nikhi-s/microgap-thermal/simulations/figures/sim1_pressure.pdf

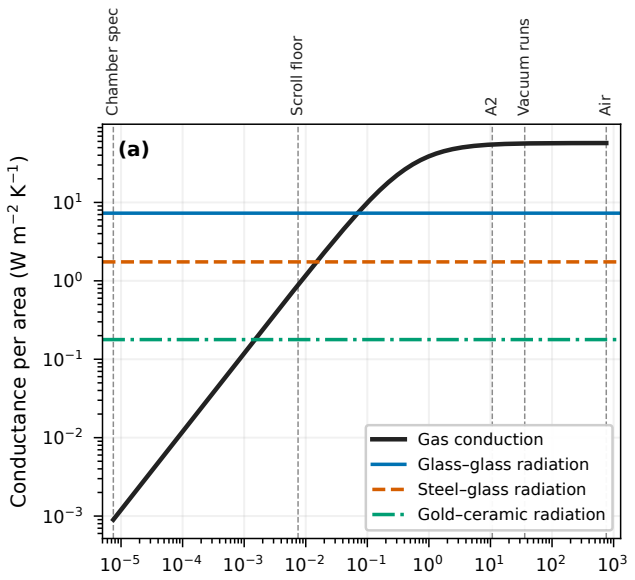
[picture p15: figure]
Conductance per area (W; Chamber spec; Scroll floor; Vacuum runs; Air; Gas conduction

### Absolute pressure (Torr)

Glass–glass radiation Steel–glass radiation Gold–ceramic radiation

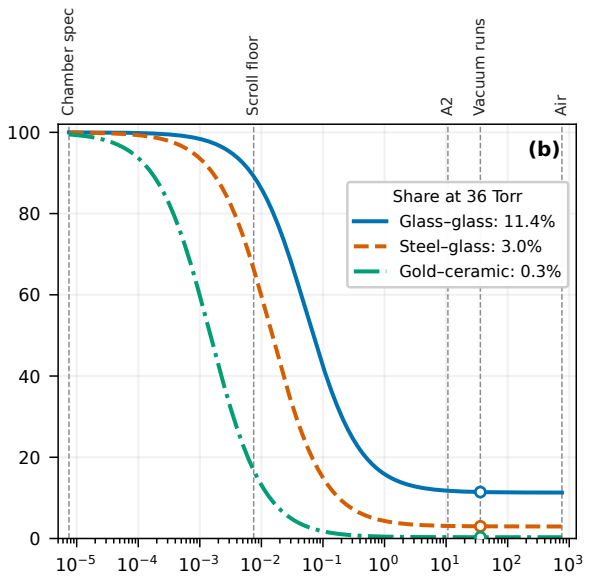
[picture p16: figure]
Chamber spec; Scroll floor; Vacuum runs; Air; Share at 36 Torr

### Absolute pressure (Torr)

### Radiation share of gap heat (%)

Glass–glass: 11.4% Steel–glass: 3.0% Gold–ceramic: 0.3%
