nikhi-s/microgap-thermal/figures/paper/fig4_pressure_map.pdf

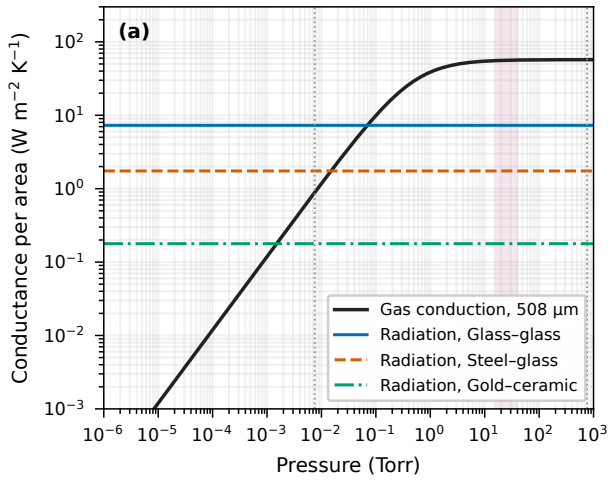
[picture p17: figure]
Pressure (Torr); Conductance per area (W; Gas conduction, 508 µm Radiation, Glass–glass Radiation, Steel–glass Radiation, Gold–ceramic
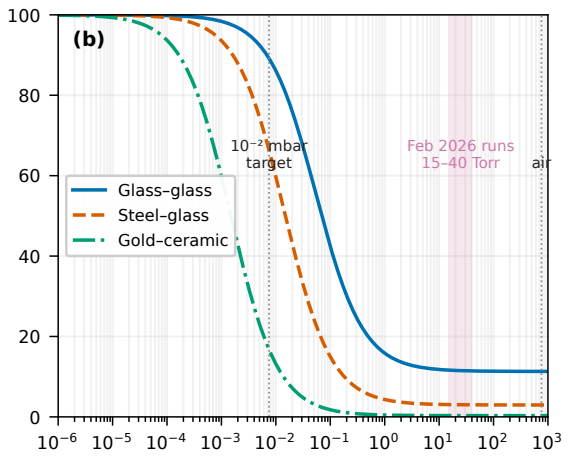
[picture p18: figure]
10⁻² mbar; target; Feb 2026 runs 15–40 Torr; air; Glass–glass Steel–glass Gold–ceramic

### Pressure (Torr)

### Radiation share of gap heat (%)
