nikhi-s/microgap-thermal/figures/paper/fig5_air_null_artifact.pdf

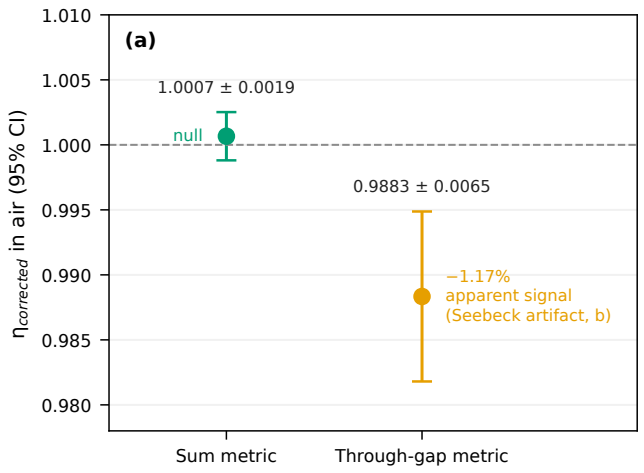
[picture p19: figure]
Sum metric; Through-gap metric; ηcorrected in air (95%; −1.17% apparent signal (Seebeck artifact, b); null
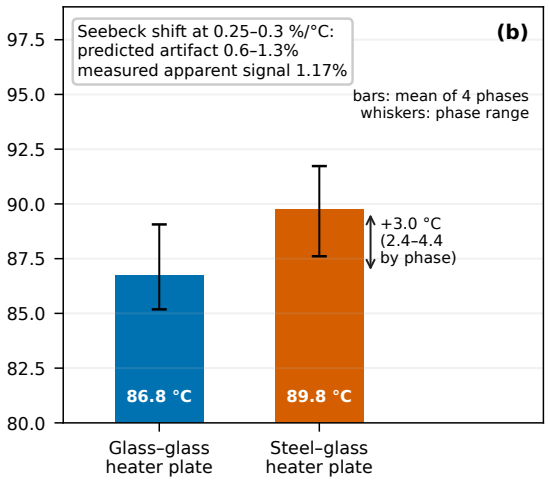
[picture p20: figure]
Glass–glass heater plate; Steel–glass heater plate; bars: mean of 4 phases whiskers: phase range; +3.0 °C (2.4–4.4 by phase); Seebeck shift at 0.25–0.3 %/°C: predicted artifact 0.6–1.3% measured apparent signal 1.17%

### Heated-plate temperature (°C)
