nikhi-s/microgap-thermal/figures/archive_2026-02/README.md

# figures/archive_2026-02/

**Superseded figures — kept for the record. Do not use in new materials.**

These are the figures used in the February 2026 competition materials (DRSEF, GENIUS Olympiad,
Sigma Xi). They are preserved unchanged so that earlier presentations and papers can be traced.
A September 2026 re-analysis of the raw logs found that several of them carry a wrong gap label,
hand-entered model curves, or a vacuum result that is not supported by the data. The current
figures are in `../paper/` (TJAS 2026 paper) and `../regenerated/`.

| File | Issue | Use instead |
|---|---|---|
| `fig7_key_result.png` | Shows the atmospheric null, not a key result; old uncertainty and p-value | `../paper/fig5_air_null_artifact` |
| `drsef_5panel_tight.png` | Reports η = 0.9325 ± 0.0016 as confirmed rectification; the result is metric-dependent and inconclusive | `../paper/fig6_vacuum_result` |
| `fig5_gap_sweep_vbot.png` | 8.5 µm label (7.62 µm), 60× (67×) | `../paper/fig3_gap_sweep` |
| `fig6_current_divider.png` | 8.5 µm label; 4.1% is from contact | `../paper/fig3_gap_sweep` |
| `fig8_allan_deviation.png` | Valid; restyled | `../paper/fig_allan_deviation` |
| `fig9_rectification_physics.png` | 8.5 µm; right panel from an old linear-pressure model | `../paper/fig4_pressure_map` |
| `fig10_vacuum_prediction.png` | Hand-entered "prediction" curves, contradicted by the measured vacuum run | `../paper/fig4_pressure_map` |

Details of the re-analysis: `../../analysis/CHANGES_2026-09.md` and `../../README.md`.
