nikhi-s/microgap-thermal/figures/fig9_rectification_physics.png

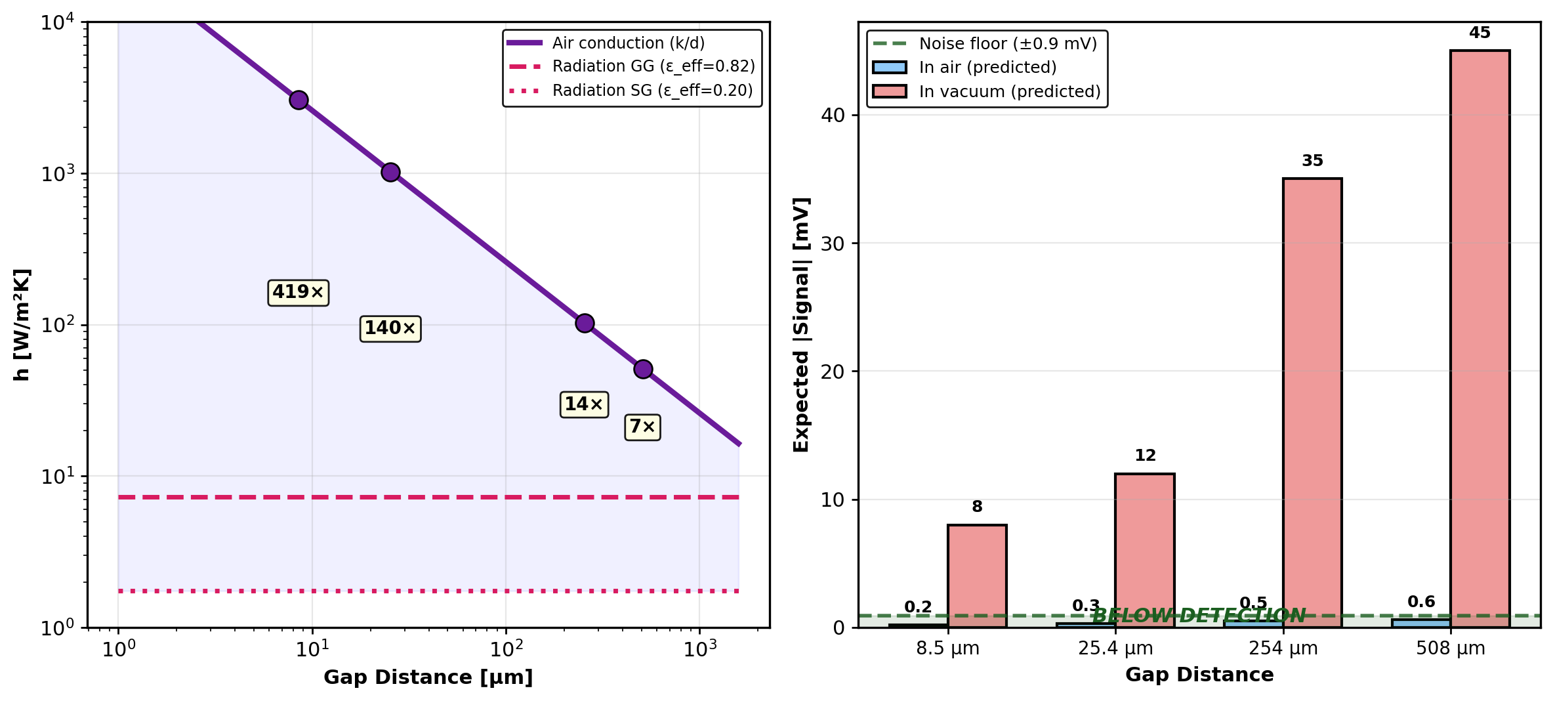
figures/fig9_rectification_physics.png
