nikhi-s/microgap-thermal/figures/figure_M1_mechanical_stack.png

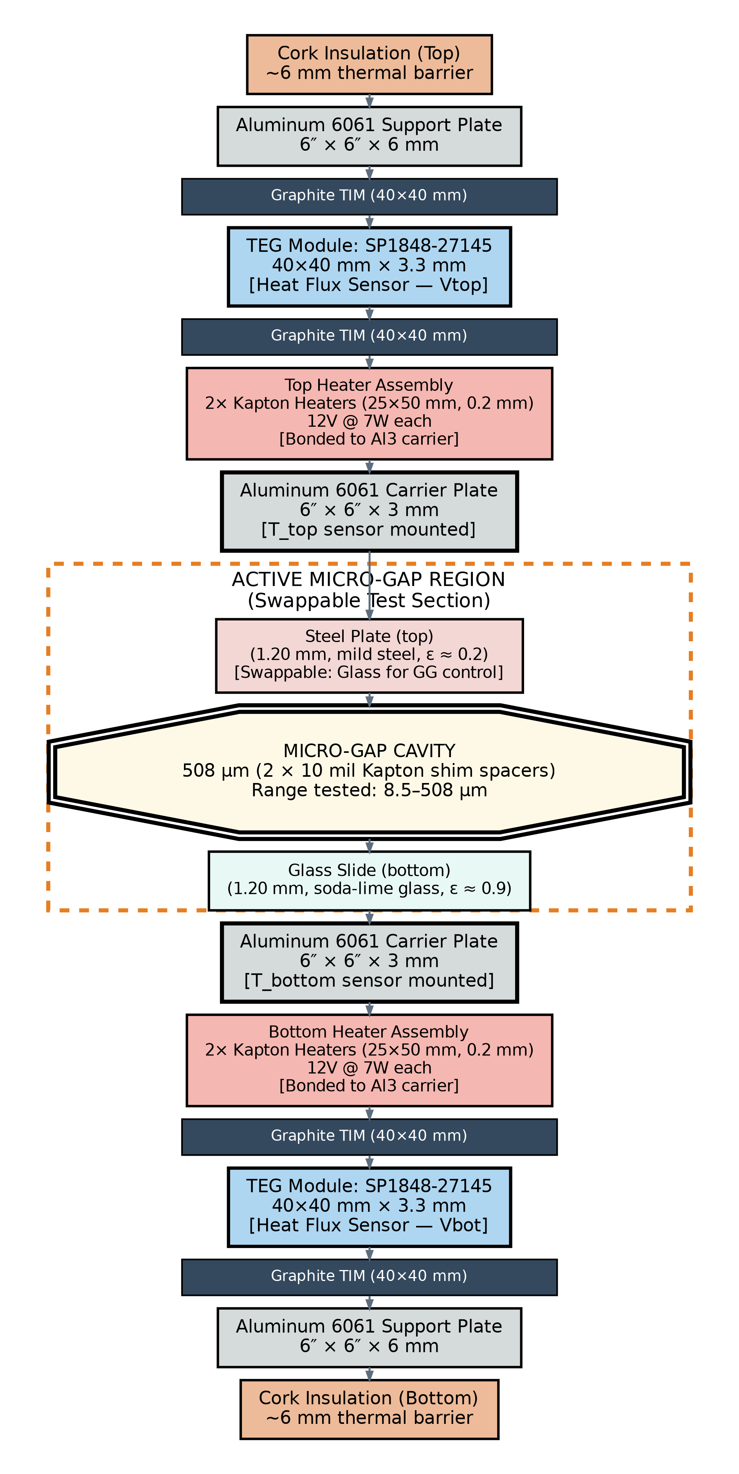
figures/figure_M1_mechanical_stack.png
