nikhi-s/microgap-thermal/figures/paper/fig3_gap_sweep.png

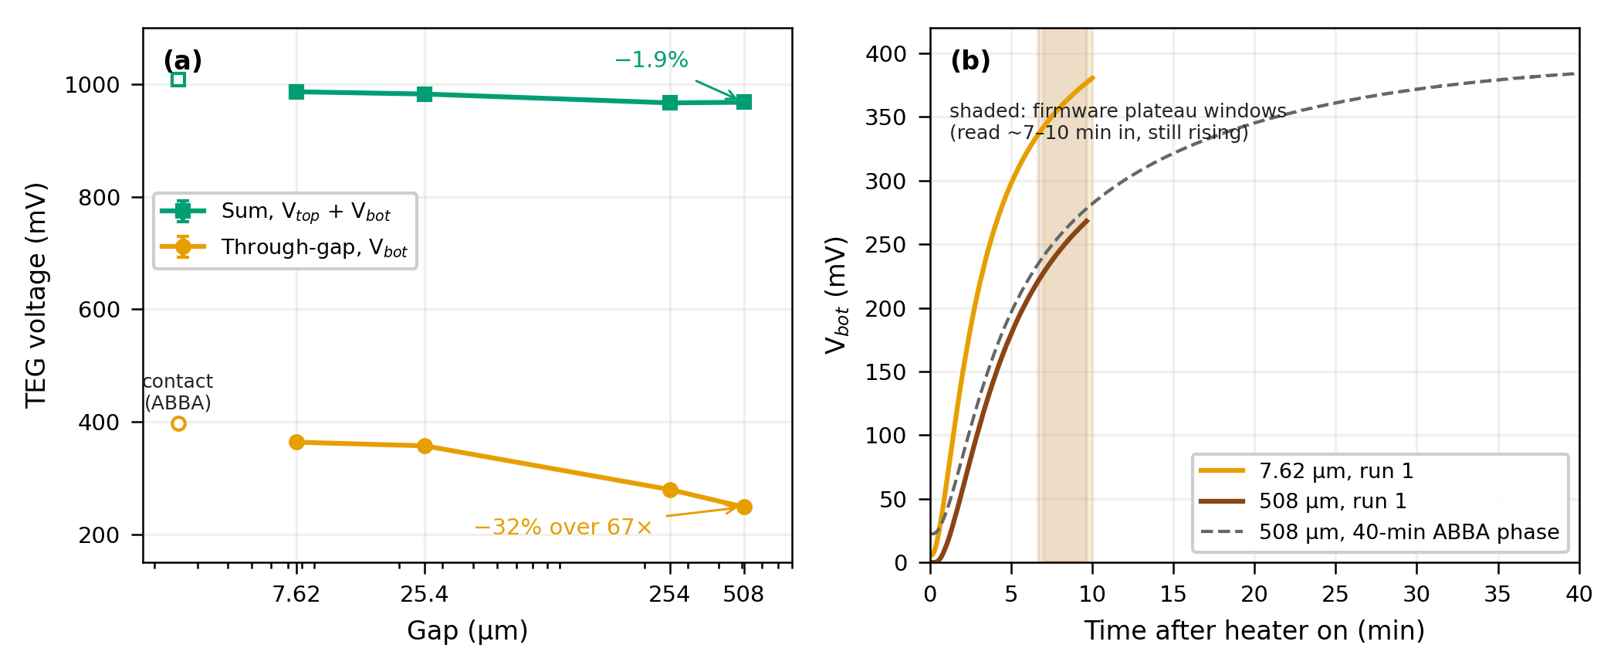
figures/paper/fig3_gap_sweep.png
