nikhi-s/microgap-thermal/figures/paper/fig4_pressure_map.png

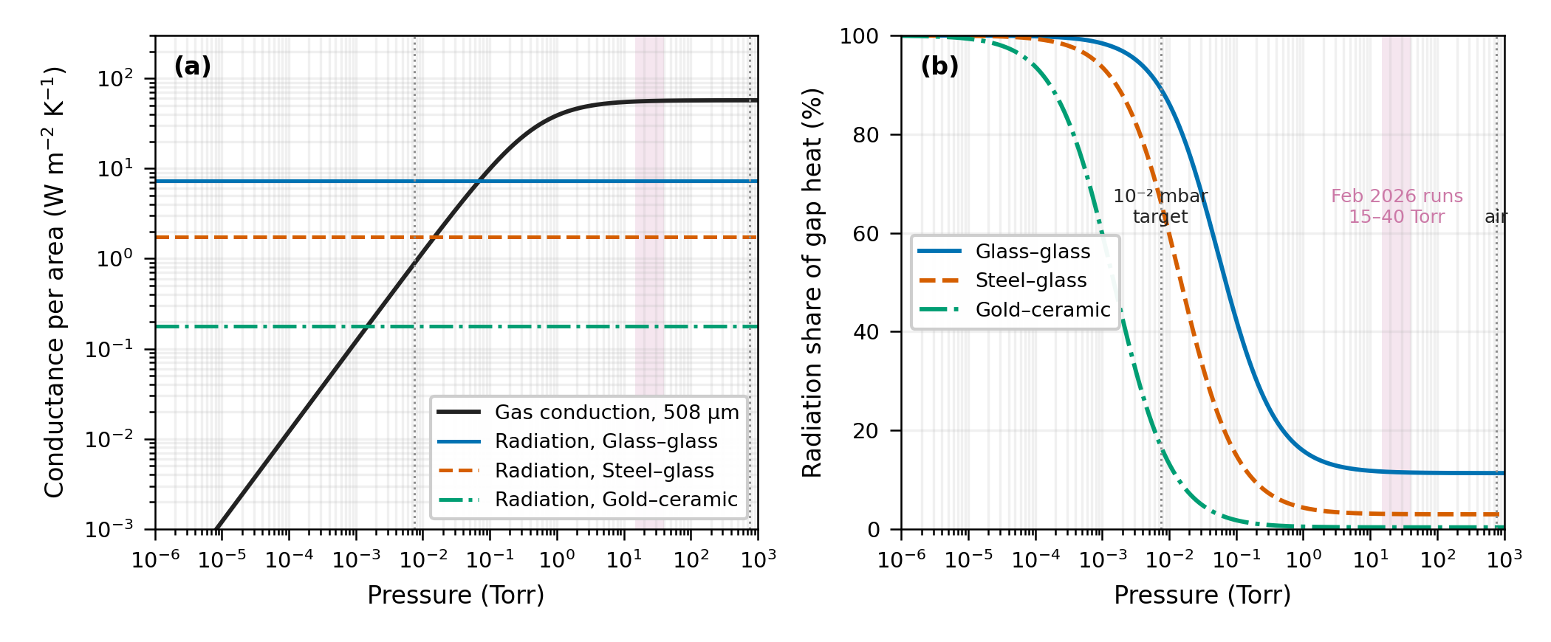
figures/paper/fig4_pressure_map.png
