nikhi-s/microgap-thermal/figures/paper/fig5_air_null_artifact.png

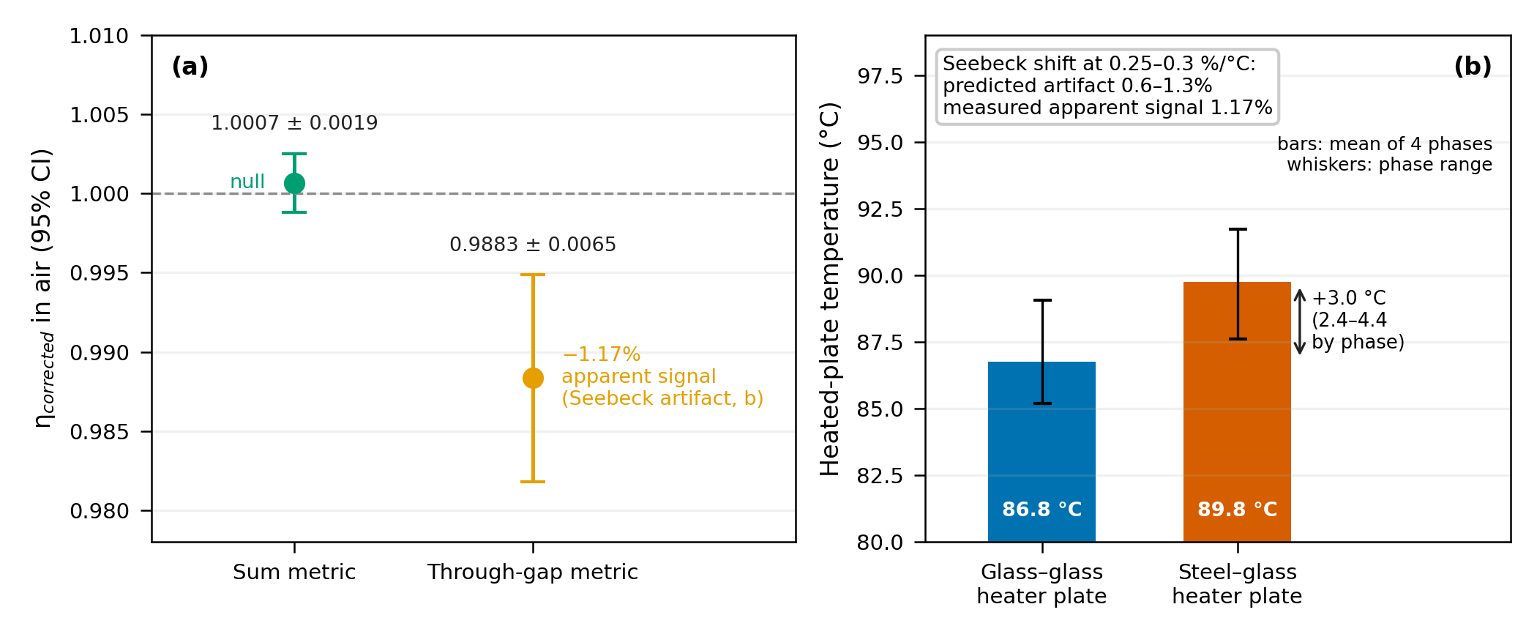
figures/paper/fig5_air_null_artifact.png
