nikhi-s/microgap-thermal/figures/paper/fig7_gap_bound.png

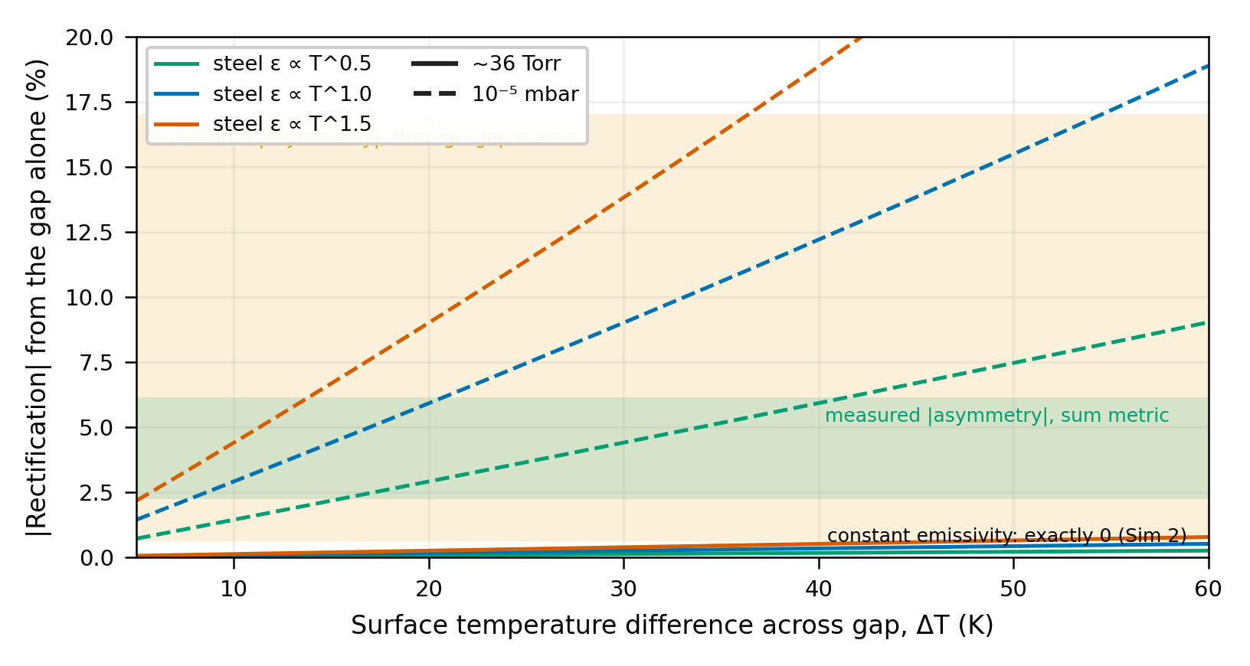
figures/paper/fig7_gap_bound.png
