nikhi-s/microgap-thermal/figures/regenerated/plot1_gap_sweep.png

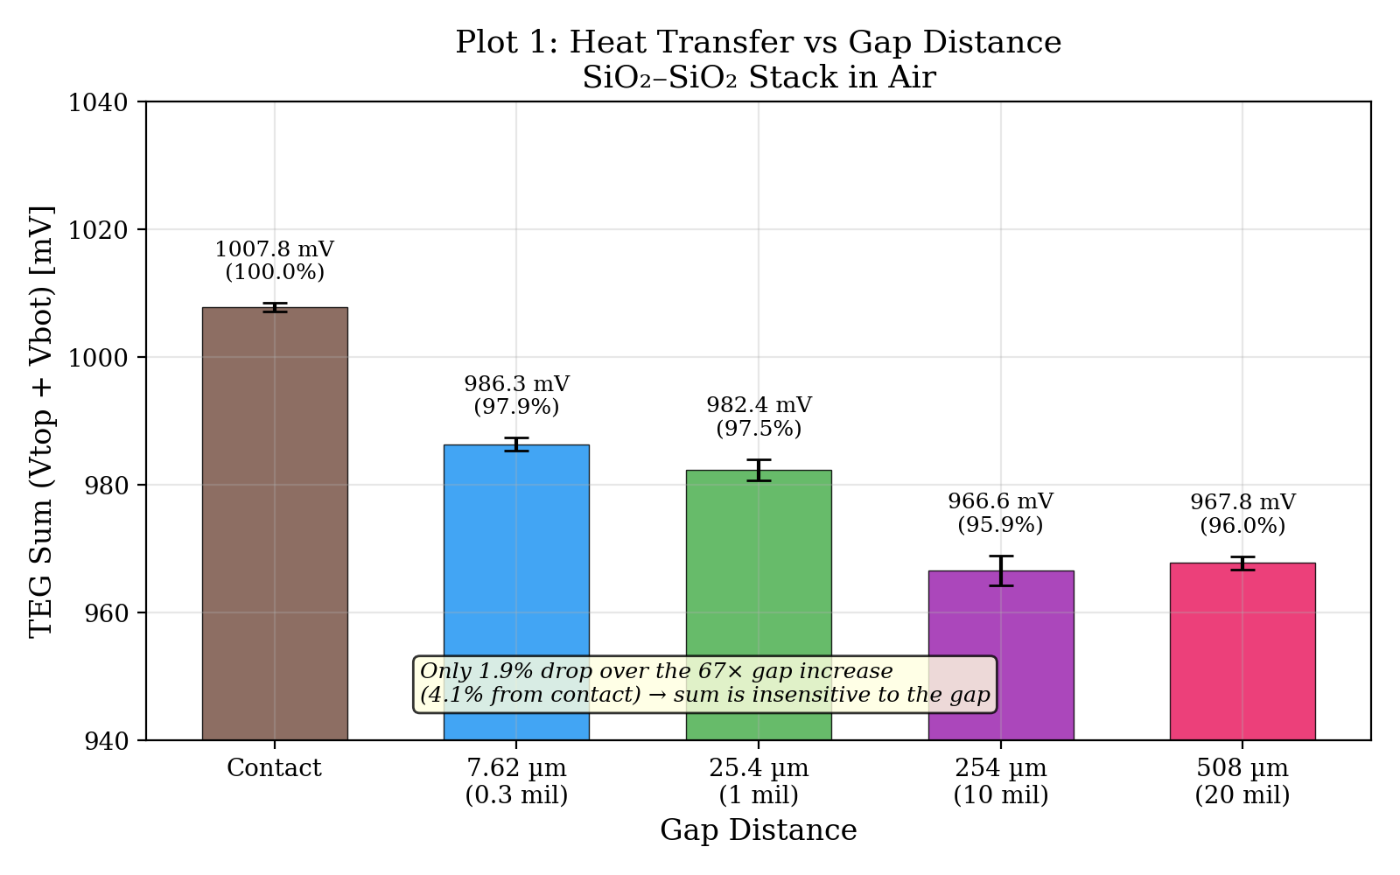
figures/regenerated/plot1_gap_sweep.png
