nikhi-s/microgap-thermal/figures/regenerated/plot2_air_vs_radiation.png

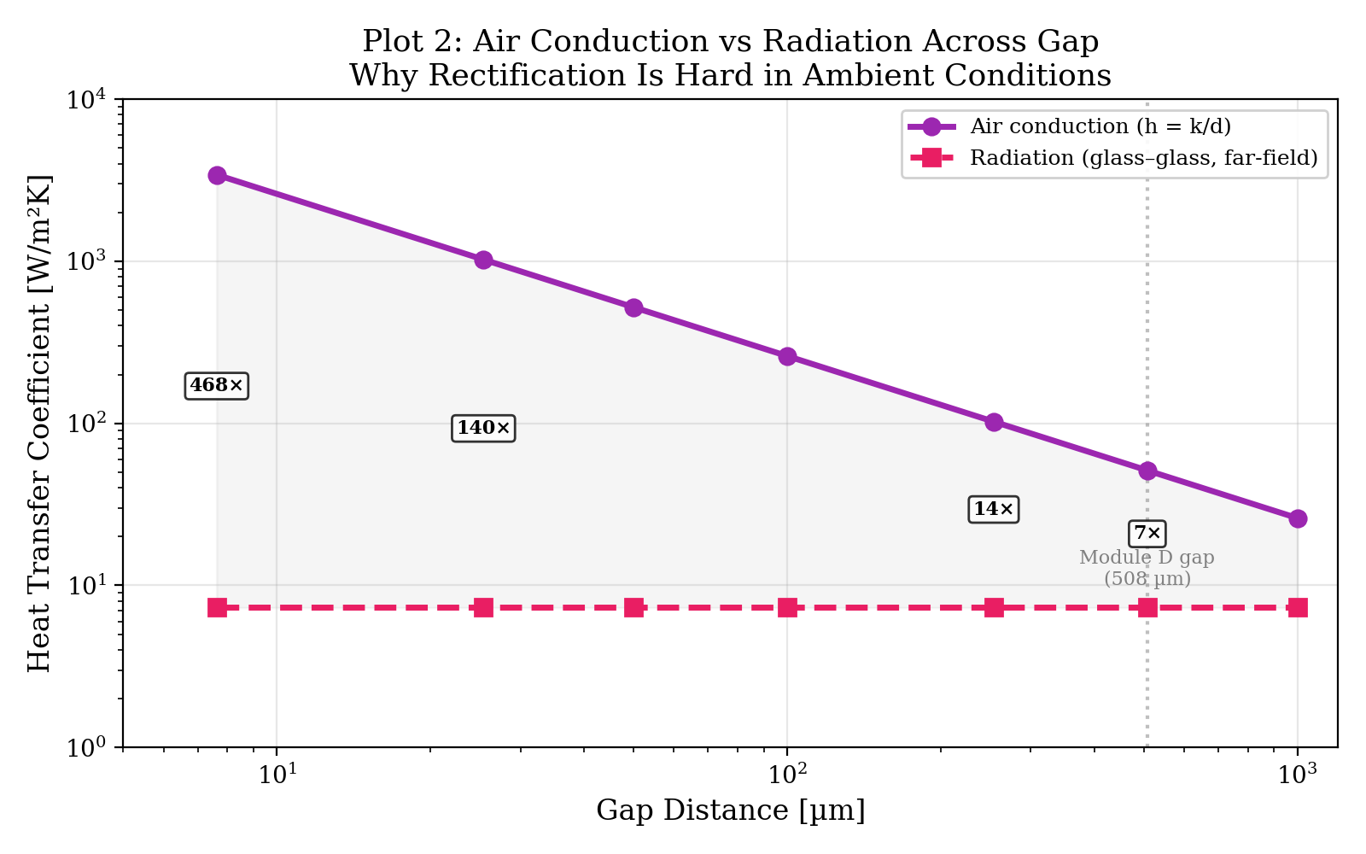
figures/regenerated/plot2_air_vs_radiation.png
