nikhi-s/microgap-thermal/figures/regenerated/plot3_abba_profile.png

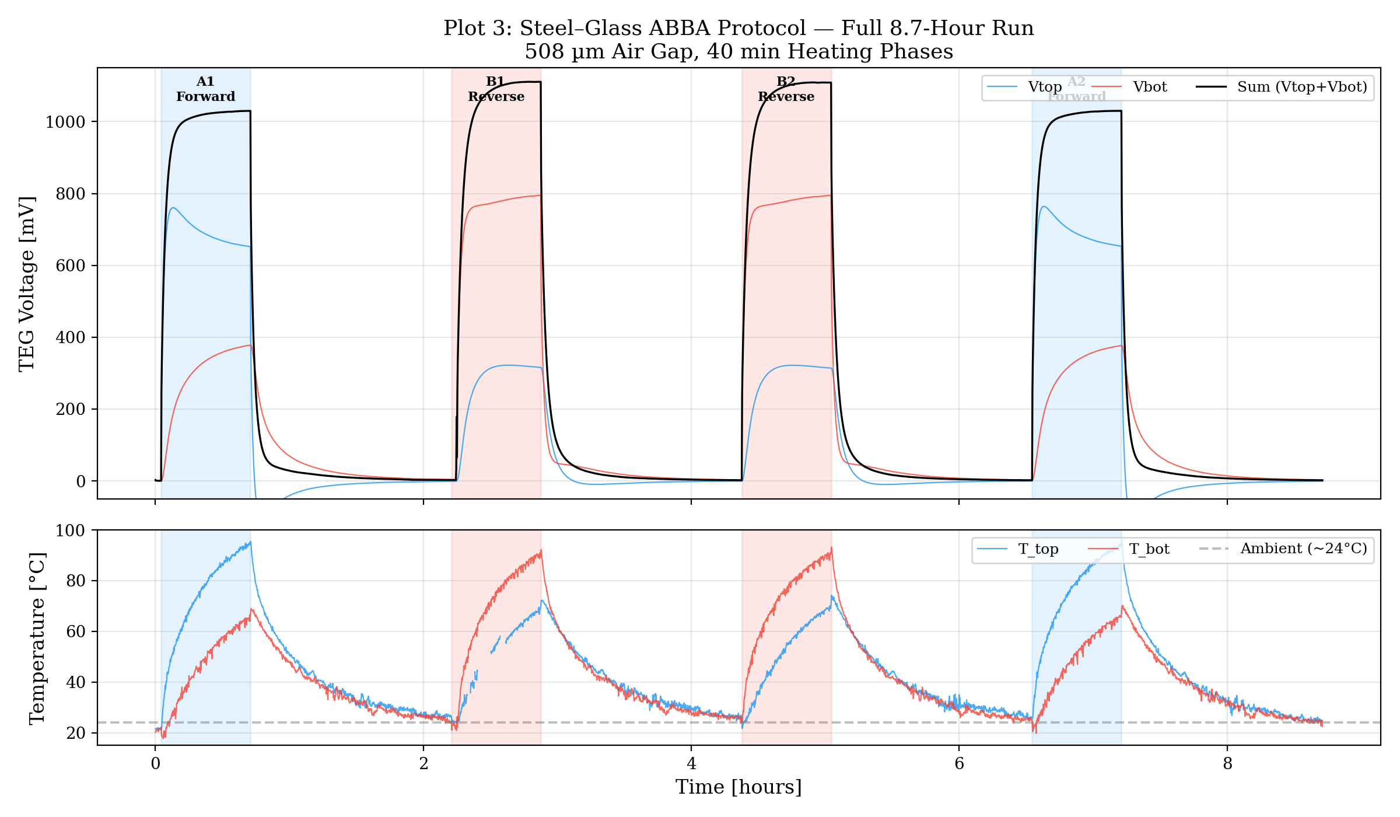
figures/regenerated/plot3_abba_profile.png
