nikhi-s/microgap-thermal/figures/regenerated/plot4_teg_mismatch.png

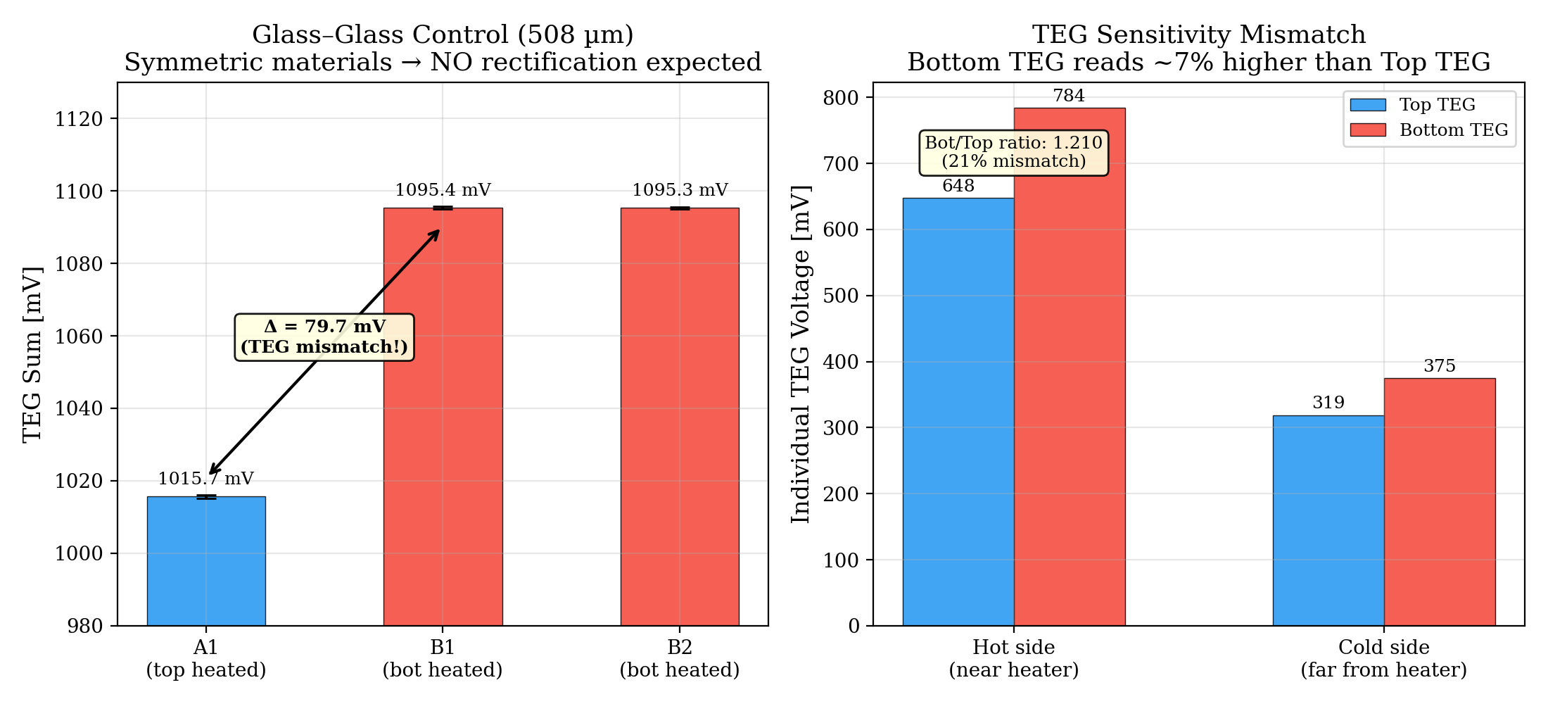
figures/regenerated/plot4_teg_mismatch.png
