nikhi-s/microgap-thermal/figures/regenerated/plot6_vtop_vbot_split.png

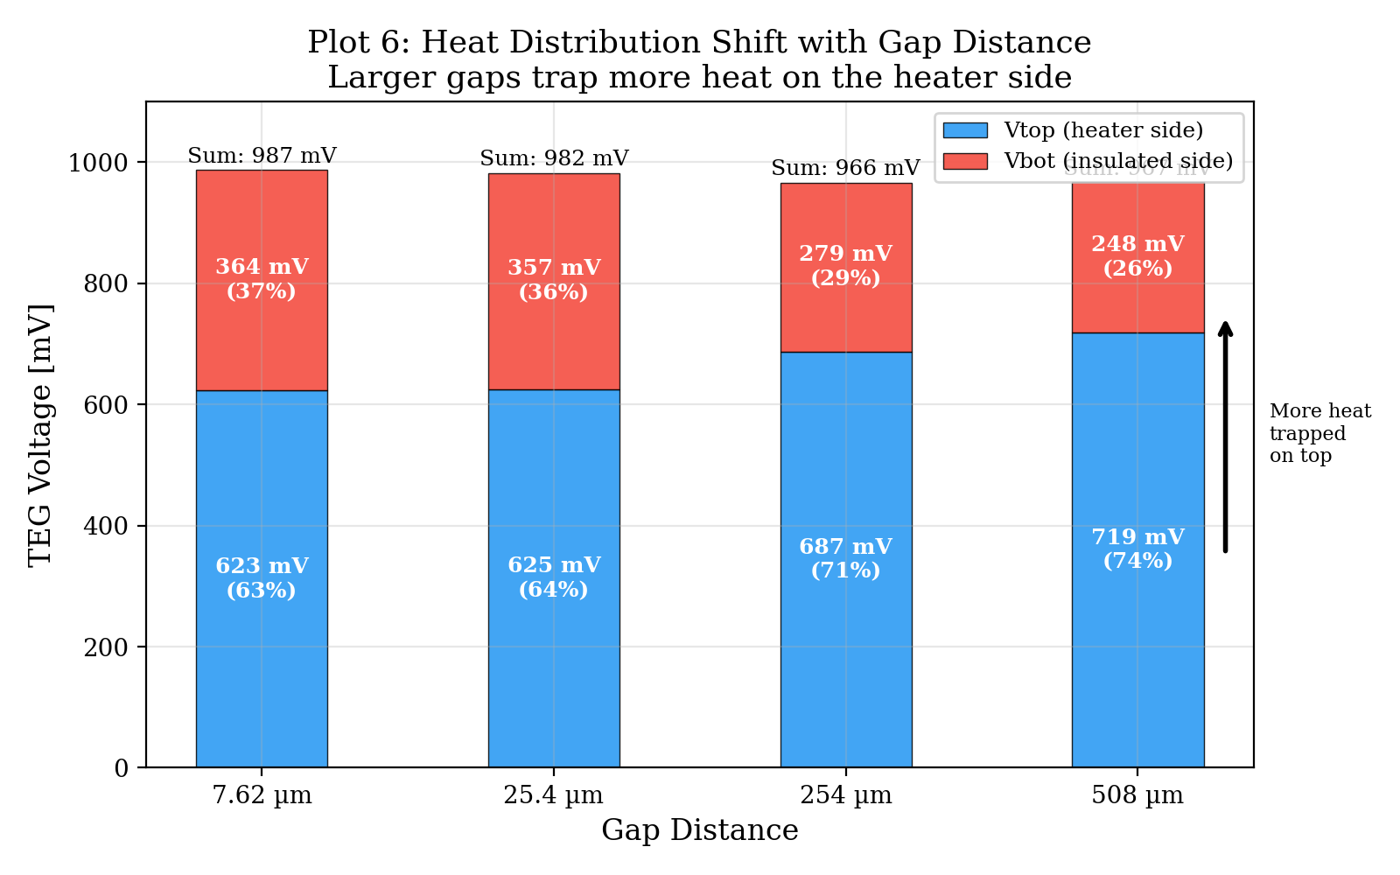
figures/regenerated/plot6_vtop_vbot_split.png
