nikhi-s/microgap-thermal/figures/regenerated/plot7_repeatability.png

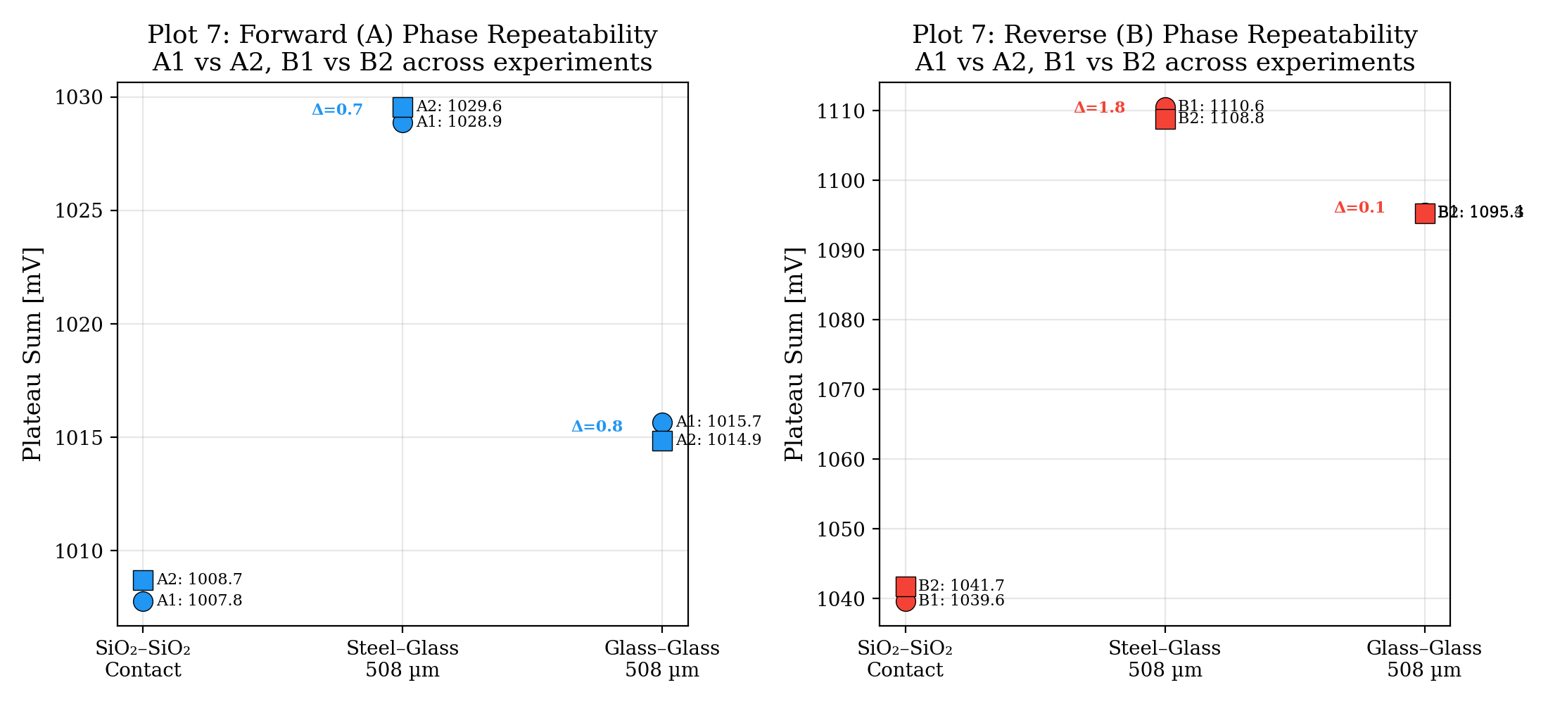
figures/regenerated/plot7_repeatability.png
