nikhi-s/microgap-thermal/figures/regenerated/plot8_vacuum_prediction.png

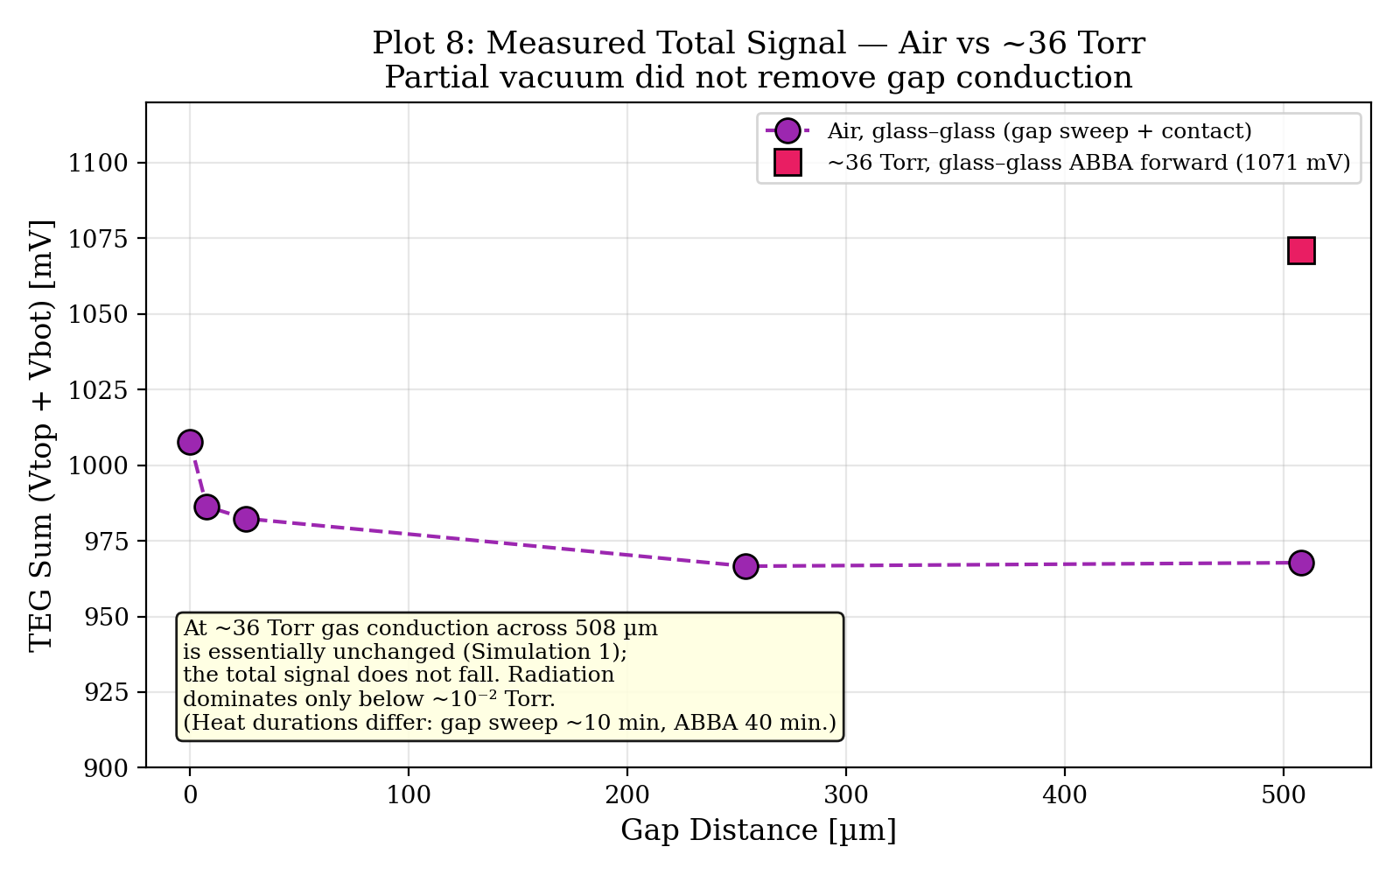
figures/regenerated/plot8_vacuum_prediction.png
