nikhi-s/microgap-thermal/figures/regenerated/plot9_allan_deviation.png

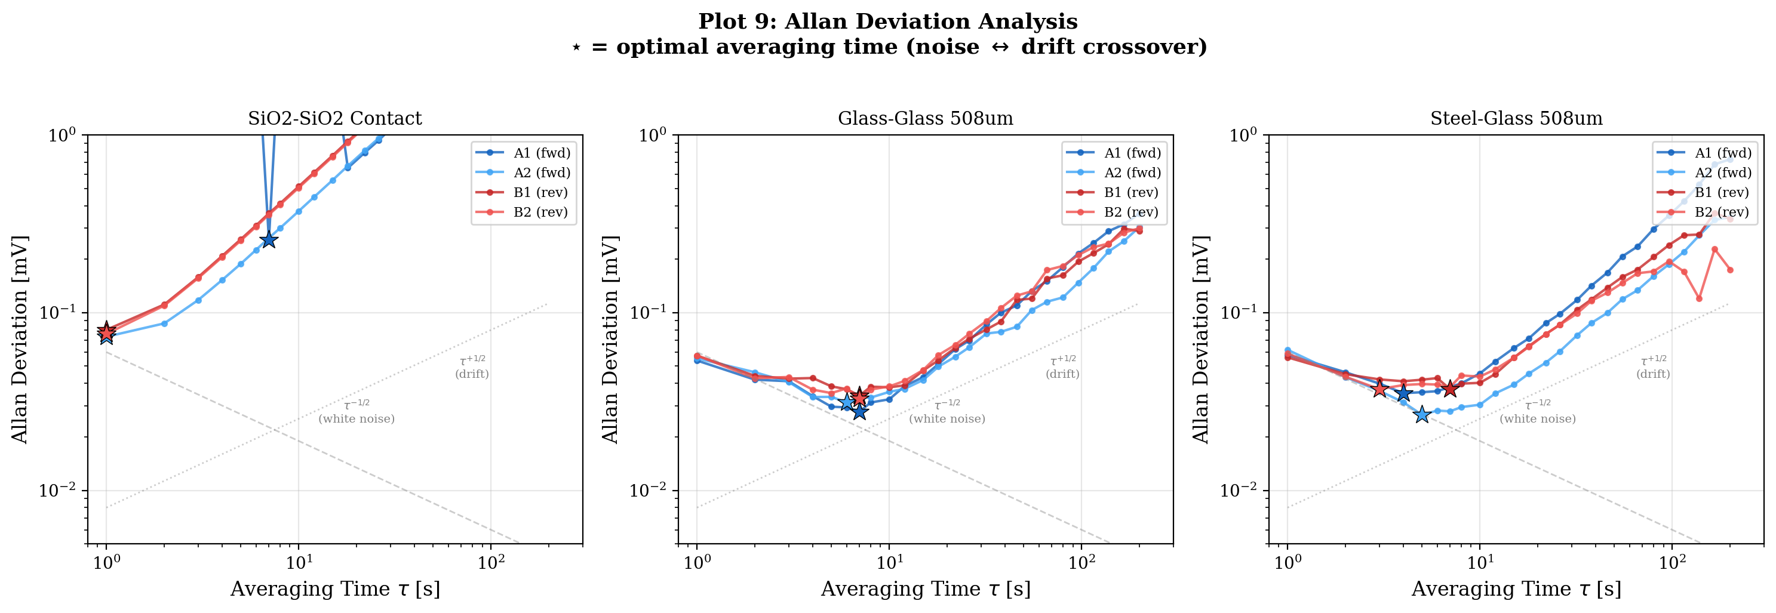
figures/regenerated/plot9_allan_deviation.png
