nikhi-s/microgap-thermal/figures/regenerated/plot10_uncertainty_budget.png

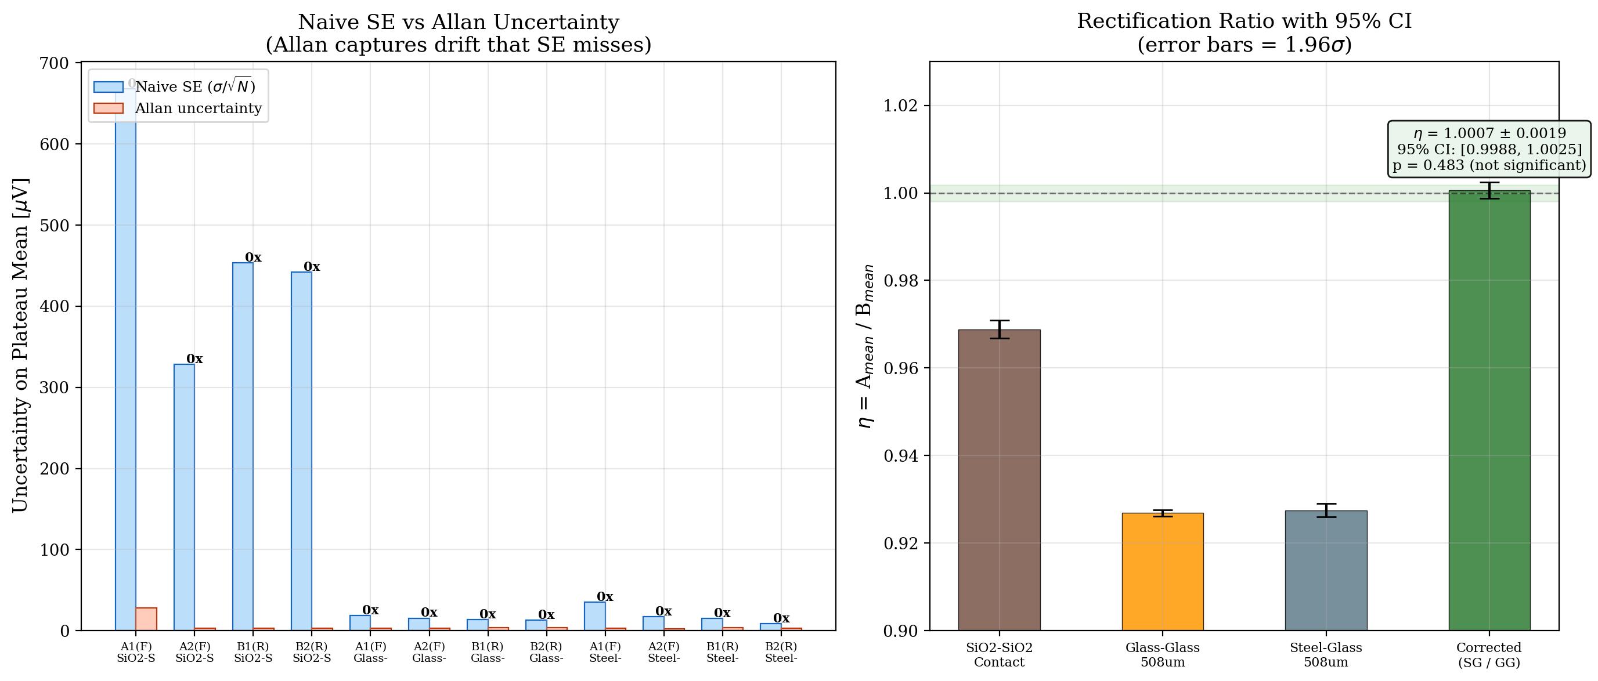
figures/regenerated/plot10_uncertainty_budget.png
