nikhi-s/microgap-thermal/figures/regenerated/plot11_plateau_stability.png

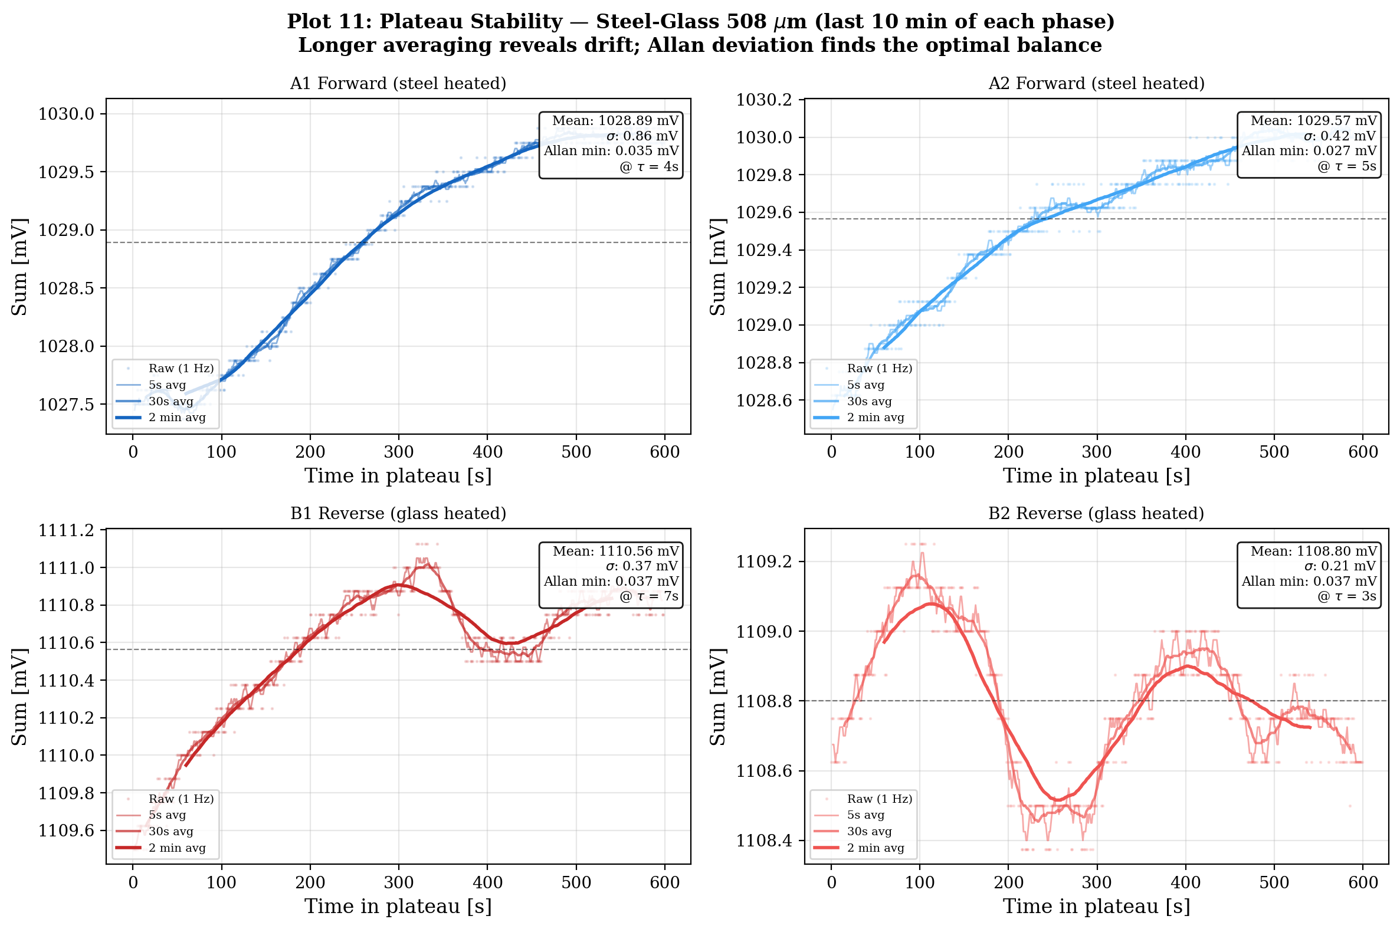
figures/regenerated/plot11_plateau_stability.png
