nikhi-s/microgap-thermal/figures/regenerated/plot12_thermal_model.png

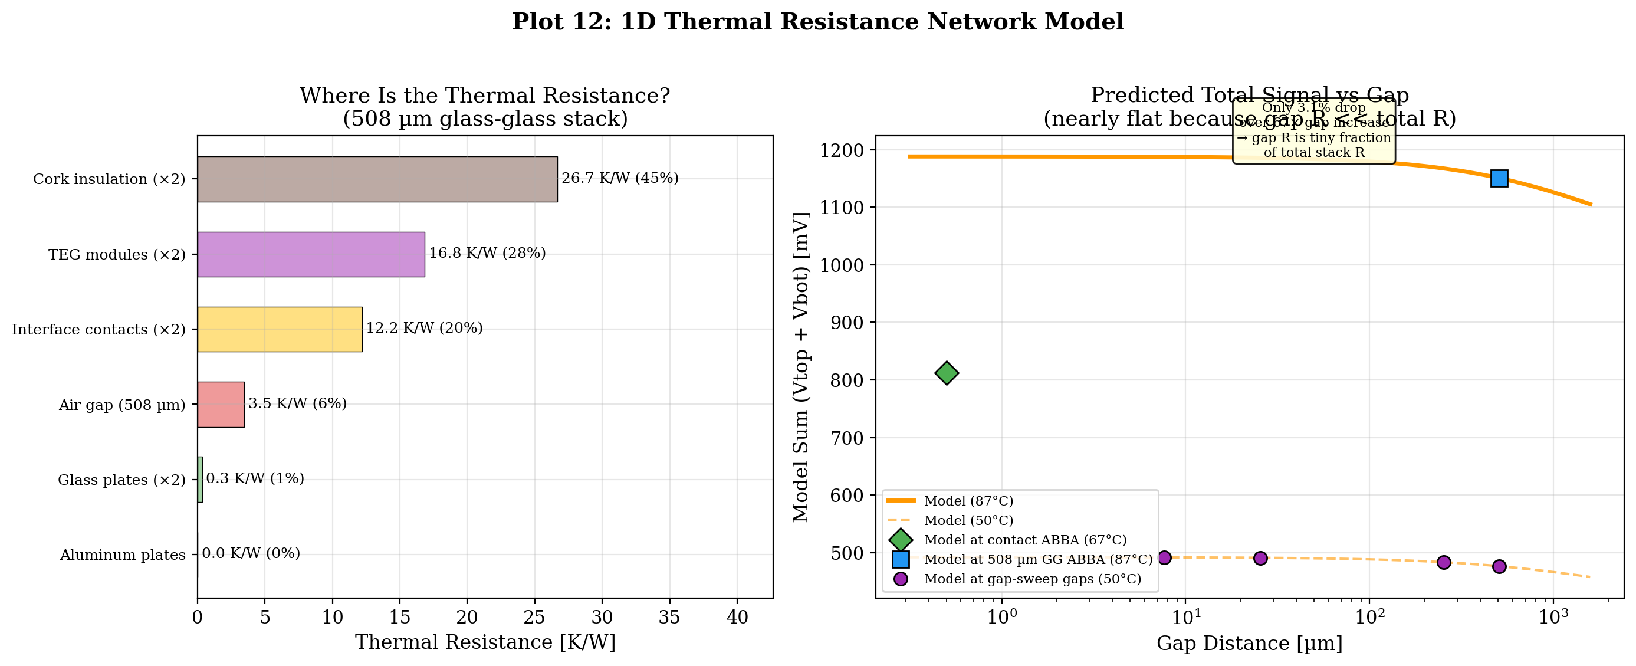
figures/regenerated/plot12_thermal_model.png
