nikhi-s/microgap-thermal/figures/regenerated/plot13_resistance_breakdown.png

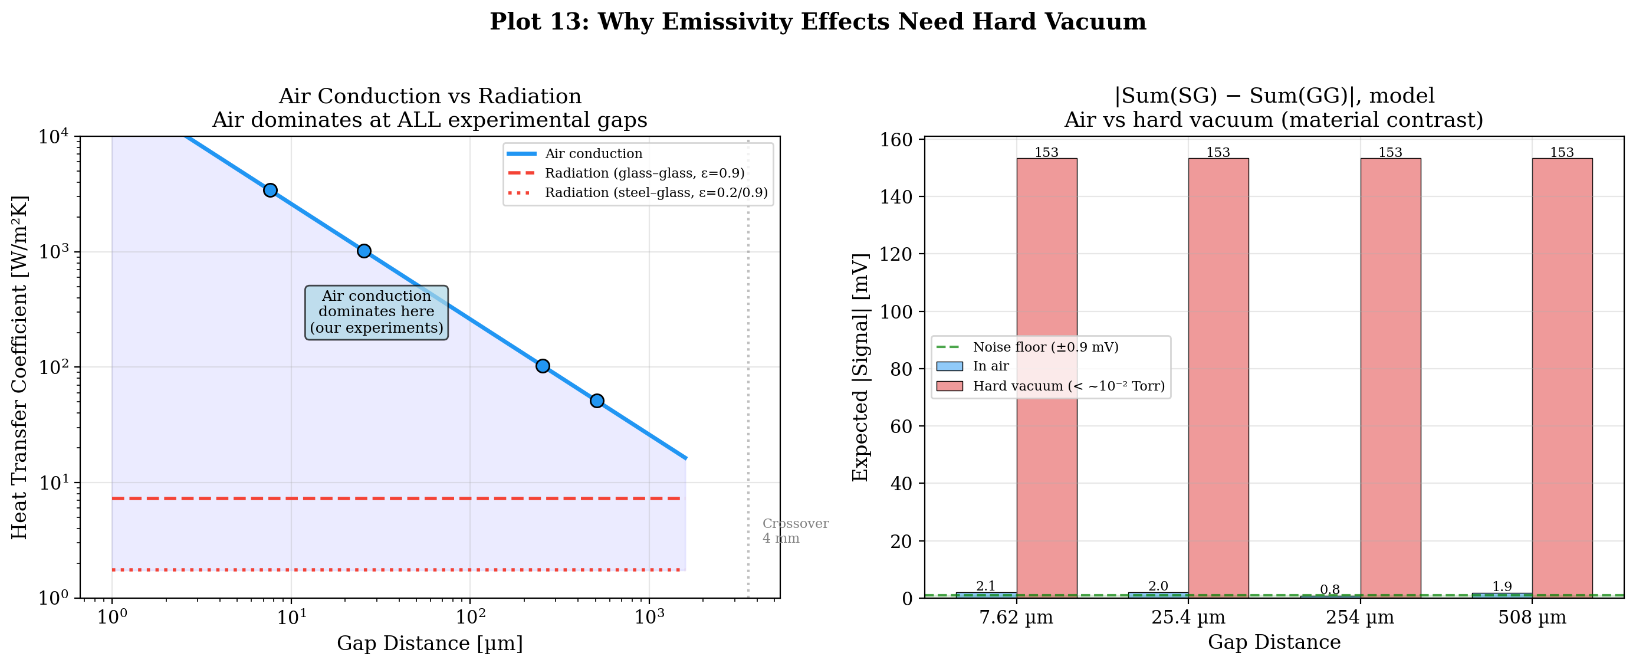
figures/regenerated/plot13_resistance_breakdown.png
