nikhi-s/microgap-thermal/figures/regenerated/plot14_rectification_physics.png

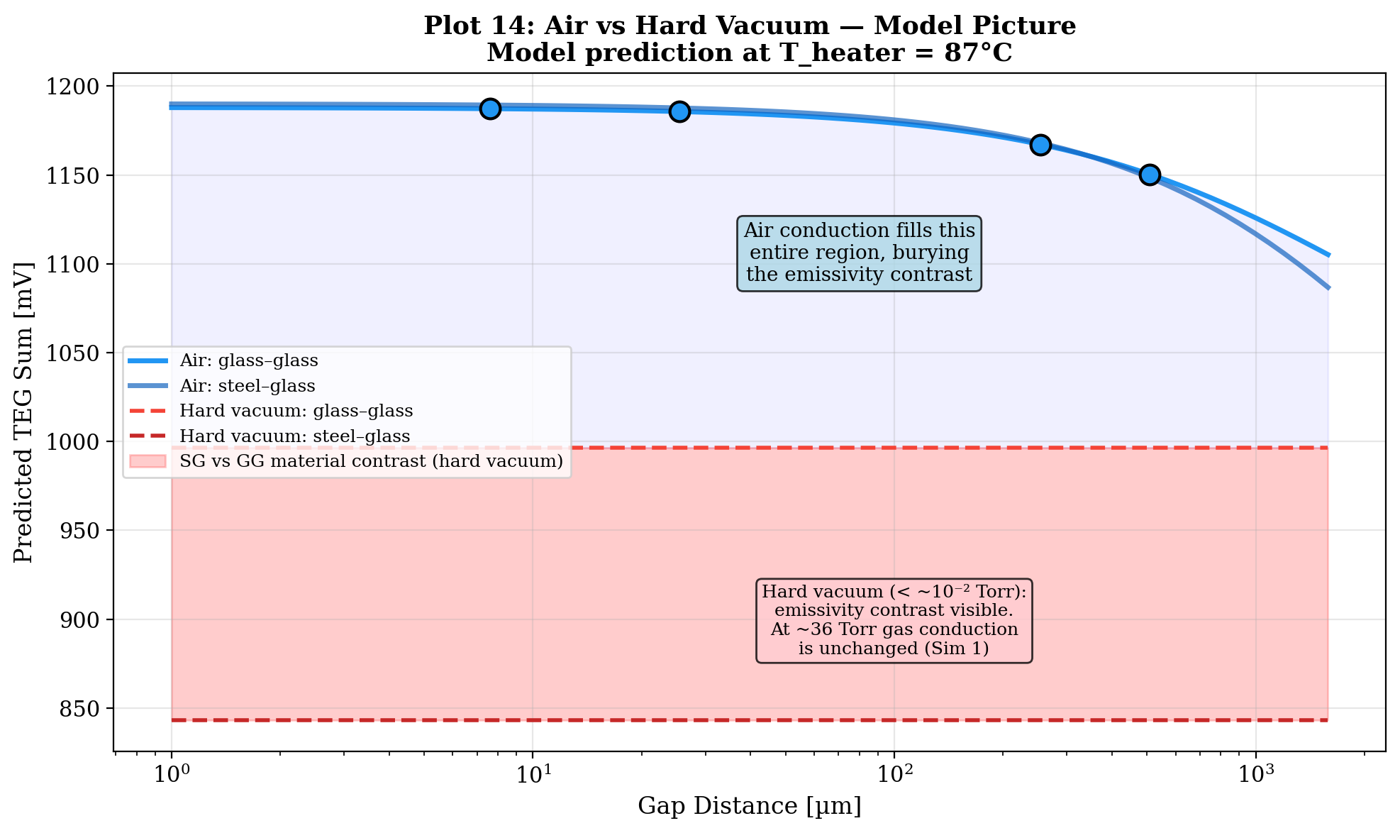
figures/regenerated/plot14_rectification_physics.png
