nikhi-s/microgap-thermal/figures/regenerated/summary_table.png

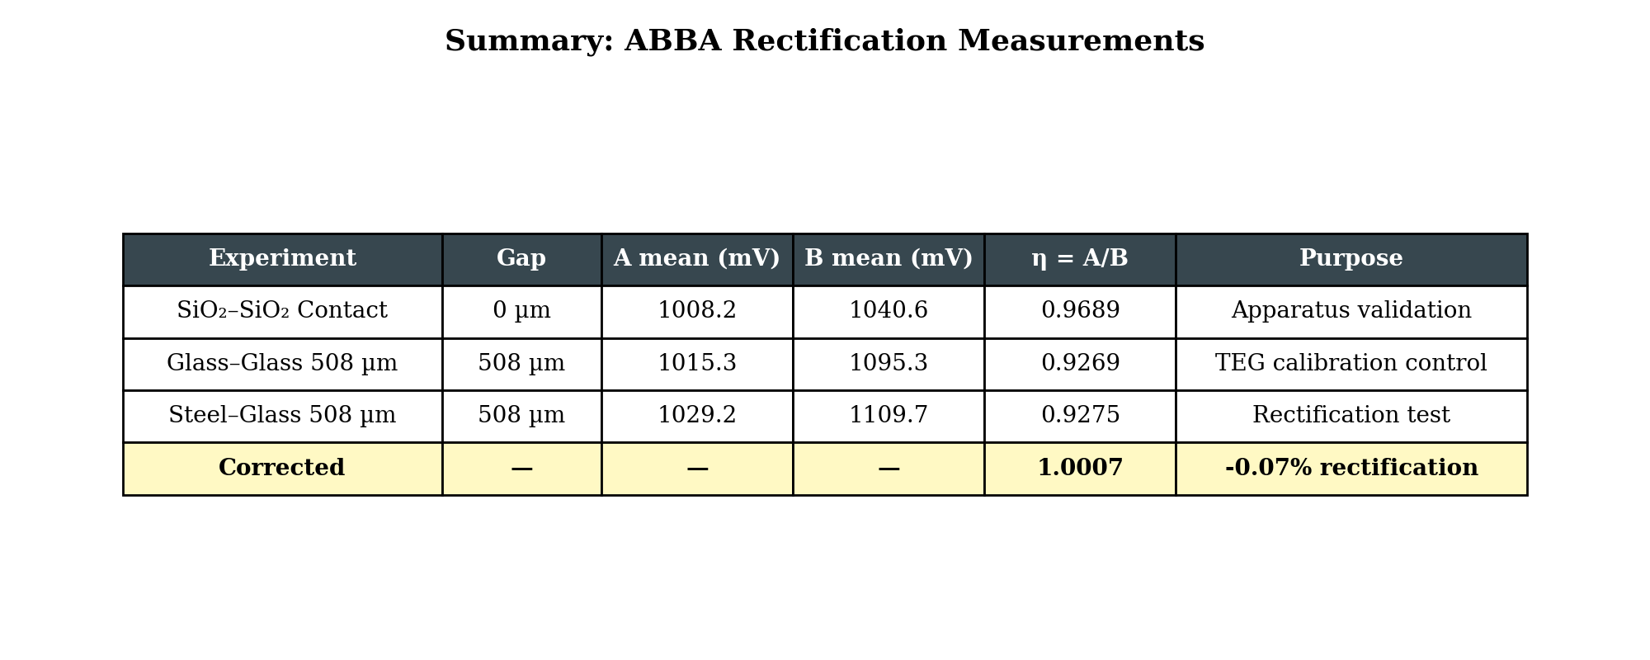
figures/regenerated/summary_table.png
