nikhi-s/microgap-thermal/figures/stack_diagram_bottom_half.png

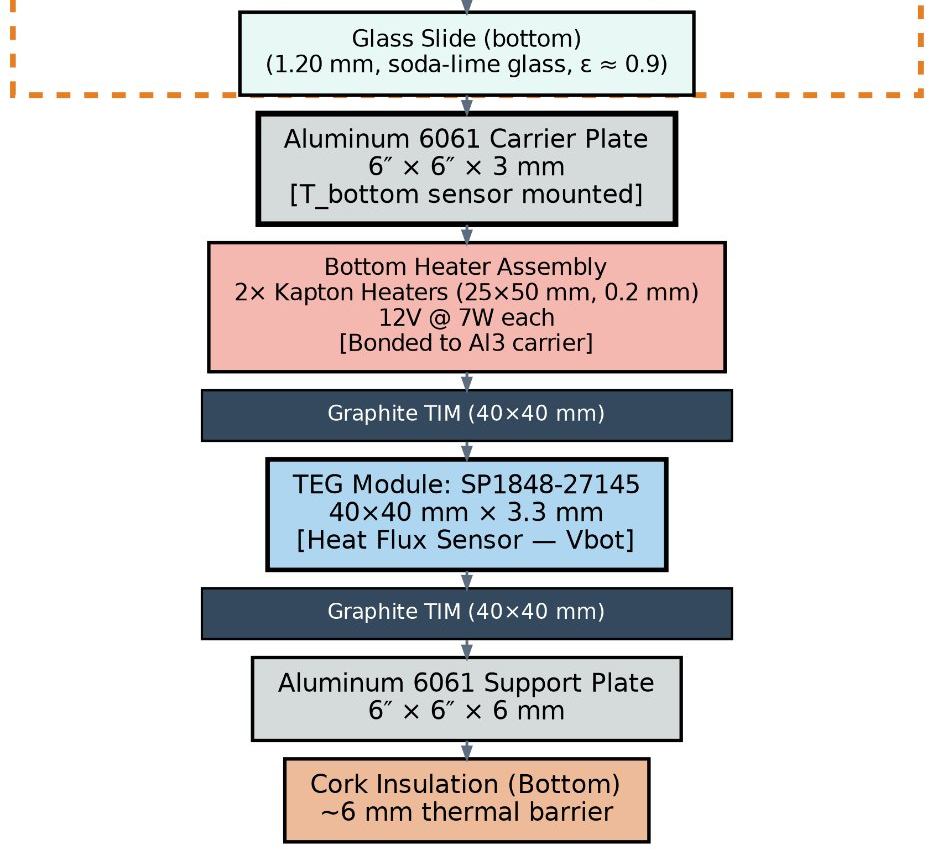
figures/stack_diagram_bottom_half.png
