nikhi-s/microgap-thermal/figures/stack_diagram_top_half.png

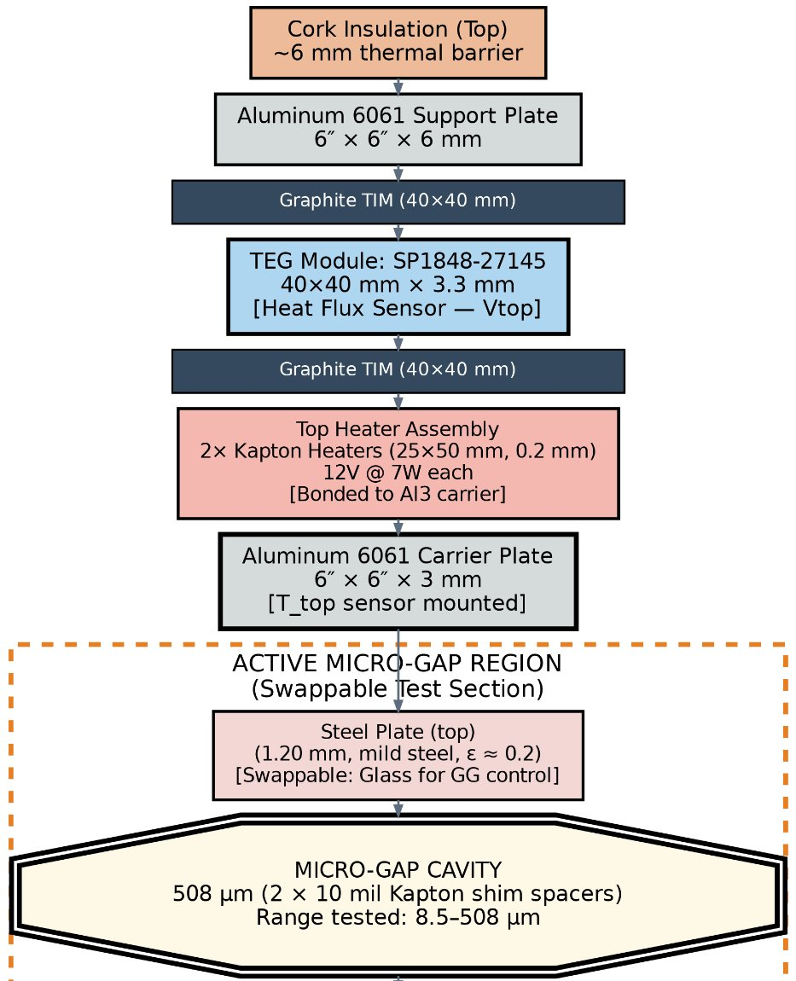
figures/stack_diagram_top_half.png
