nikhi-s/microgap-thermal/simulations/results/sim1_key_values.csv

pair | condition | pressure_Pa | pressure_Torr | G_rad_W_m2K | G_gas_W_m2K | radiation_fraction
glass-glass | 760 Torr (air runs) | 101324.72 | 760.0 | 7.293393163636362 | 57.188093820398514 | 0.11310832775060152
glass-glass | 36 Torr (vacuum runs) | 4799.592000000001 | 36.0 | 7.293393163636362 | 56.47554559863974 | 0.11437218973998242
glass-glass | 10.7 Torr (A2 phase) | 1426.5454 | 10.7 | 7.293393163636362 | 54.78138938885491 | 0.11749365625999529
glass-glass | Scroll-pump floor (1e-2 mbar) | 0.999915 | 0.0075 | 7.293393163636362 | 0.8856486266534377 | 0.89171731244791
glass-glass | New chamber spec (1e-5 mbar) | 0.000999915 | 7.5e-06 | 7.293393163636362 | 0.0008995570365303312 | 0.9998766765921004
glass-glass | Exactly 1 Pa (1e-2 mbar) | 1.0 | 0.007500637554192106 | 7.293393163636362 | 0.885722747888253 | 0.8917092314781548
glass-glass | Radiation fraction 50% | 9.291130311759 | 0.06968940093727216 | 7.293393163636362 | 7.293393163636168 | 0.5
glass-glass | Radiation fraction 90% | 0.9137110736209078 | 0.006853415592482169 | 7.293393163636362 | 0.8103770181817115 | 0.9
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
