nikhi-s/microgap-thermal/simulations/results/sim1_pressure_sweep.csv

pressure_Torr | pressure_Pa | G_gas_W_m2K | glass-glass_G_rad_W_m2K | glass-glass_radiation_fraction | steel-glass_G_rad_W_m2K | steel-glass_radiation_fraction | gold-ceramic_G_rad_W_m2K | gold-ceramic_radiation_fraction
1e-05 | 0.0013332200000000002 | 0.0011994030971971947 | 7.293393163636362 | 0.9998355764100292 | 1.7440722782608695 | 0.9993127699773001 | 0.17809547507886436 | 0.993310444172201
1.0370345212526297e-05 | 0.001382595164424431 | 0.0012438214511919278 | 7.293393163636362 | 0.9998294882317331 | 1.7440722782608695 | 0.9992873374333755 | 0.17809547507886436 | 0.9930644232733261
1.0754405982696687e-05 | 0.0014337989144250878 | 0.0012898847448255106 | 7.293393163636362 | 0.999823174668965 | 1.7440722782608695 | 0.9992609644163455 | 0.17809547507886436 | 0.9928094201996569
1.1152690259622275e-05 | 0.001486898970793361 | 0.0013376538921553488 | 7.293393163636362 | 0.9998166273813777 | 1.7440722782608695 | 0.9992336162024096 | 0.17809547507886436 | 0.9925451119320815
1.1565724804066228e-05 | 0.0015419655623277176 | 0.0013871920627472932 | 7.293393163636362 | 0.9998098377202456 | 1.7440722782608695 | 0.9992052567897838 | 0.17809547507886436 | 0.9922711642029879
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
