nikhi-s/microgap-thermal/simulations/results/sim2_pressure_sweep.csv

n | b_per_K | dT_K | pressure_Torr | R_total_percent
0.5 | 0.0 | 20.0 | 1e-06 | 2.919692656908035
0.5 | 0.0 | 20.0 | 1.052586215278033e-06 | 2.9196819527585127
0.5 | 0.0 | 20.0 | 1.1079377405933336e-06 | 2.919670685805631
0.5 | 0.0 | 20.0 | 1.1661999931348297e-06 | 2.9196588264631007
0.5 | 0.0 | 20.0 | 1.2275260370310584e-06 | 2.9196463435898323
0.5 | 0.0 | 20.0 | 1.2920769854737643e-06 | 2.9196332044082673
0.5 | 0.0 | 20.0 | 1.3600224239876796e-06 | 2.9196193744184695
0.5 | 0.0 | 20.0 | 1.431540855958445e-06 | 2.9196048173076417
0.5 | 0.0 | 20.0 | 1.5068201715891755e-06 | 2.9195894948550016
0.5 | 0.0 | 20.0 | 1.5860581415176464e-06 | 2.919573366831507
0.5 | 0.0 | 20.0 | 1.6694629363909702e-06 | 2.919556390894562
0.5 | 0.0 | 20.0 | 1.7572536737627194e-06 | 2.9195385224770165
0.5 | 0.0 | 20.0 | 1.84966099374932e-06 | 2.9195197146703933
0.5 | 0.0 | 20.0 | 1.9469276649580022e-06 | 2.919499918102053
0.5 | 0.0 | 20.0 | 2.0493092222782416e-06 | 2.9194790808058313
0.5 | 0.0 | 20.0 | 2.157074638212219e-06 | 2.9194571480860354
0.5 | 0.0 | 20.0 | 2.2705070295080322e-06 | 2.9194340623742265
0.5 | 0.0 | 20.0 | 2.3899044009520287e-06 | 2.919409763078451
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
