nikhi-s/microgap-thermal/simulations/results/sim2_radiation_only.csv

n | b_per_K | dT_K | R_rad | q_rad_fwd_W_m2 | q_rad_rev_W_m2
-0.5 | 0.0 | 5.0 | -0.007167412517065985 | 8.689637411587954 | 8.752369252522467
-0.5 | 0.0 | 10.0 | -0.014284205549296436 | 17.32036226359843 | 17.57135511179499
-0.5 | 0.0 | 20.0 | -0.02837030797104112 | 34.42003508664188 | 35.42505480124419
-0.5 | 0.0 | 40.0 | -0.05598196528259691 | 68.07363122104455 | 72.11051983919222
-0.5 | -0.0002 | 5.0 | -0.006927563793907132 | 8.690682675701364 | 8.75130791959448
-0.5 | -0.0002 | 10.0 | -0.013807858598676614 | 17.324512539622983 | 17.5670762443978
-0.5 | -0.0002 | 20.0 | -0.027430760375928065 | 34.43640041352898 | 35.407659434961886
-0.5 | -0.0002 | 40.0 | -0.05415350803022334 | 68.13736554143499 | 72.03850320313101
0.0 | 0.0 | 5.0 | 0.0 | 8.720832864130436 | 8.720832864130436
0.0 | 0.0 | 10.0 | 0.0 | 17.44449456521739 | 17.44449456521739
0.0 | 0.0 | 20.0 | 0.0 | 34.911619826086955 | 34.911619826086955
0.0 | 0.0 | 40.0 | 0.0 | 70.0042852173913 | 70.0042852173913
0.0 | -0.0002 | 5.0 | 0.000241575127811533 | 8.721885647082791 | 8.719779165316442
0.0 | -0.0002 | 10.0 | 0.0004832089714508214 | 17.44870455039096 | 17.440277251958225
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
