nikhi-s/microgap-thermal/simulations/results/sim2_rectification.csv

n | b_per_K | dT_K | pressure_Torr | pressure_Pa | R_rad | f_rad | f_rad_reverse | R_total | q_rad_fwd_W_m2 | q_rad_rev_W_m2 | q_gas_W_m2 | q_total_fwd_W_m2 | q_total_rev_W_m2
0.5 | 0.0 | 5.0 | 760.0 | 101324.72 | 0.007219159438158762 | 0.029594572772721223 | 0.029492622026012254 | 0.00021291194065509167 | 8.752137809694952 | 8.68940759087329 | 285.94046910199256 | 294.6926069116875 | 294.6298766928659
0.5 | 0.0 | 5.0 | 36.0 | 4799.592000000001 | 0.007219159438158762 | 0.029956779894167816 | 0.029853619761766047 | 0.00021551804086628046 | 8.752137809694952 | 8.68940759087329 | 282.37772799319873 | 291.1298658028937 | 291.06713558407205
0.5 | 0.0 | 5.0 | 0.0075 | 0.999915 | 0.007219159438158762 | 0.6632157332748215 | 0.6624210213862556 | 0.004782122968575386 | 8.752137809694952 | 8.68940759087329 | 4.4282431332671885 | 13.180380942962142 | 13.117650724140479
0.5 | 0.0 | 5.0 | 7.5e-06 | 0.000999915 | 0.007219159438158762 | 0.9994844862144281 | 0.999482650777976 | 0.00721542461163982 | 8.752137809694952 | 8.68940759087329 | 0.004497785182651656 | 8.756635594877604 | 8.693905376055943
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
