nikhi-s/microgap-thermal/figures/paper/fig6_vacuum_result.png

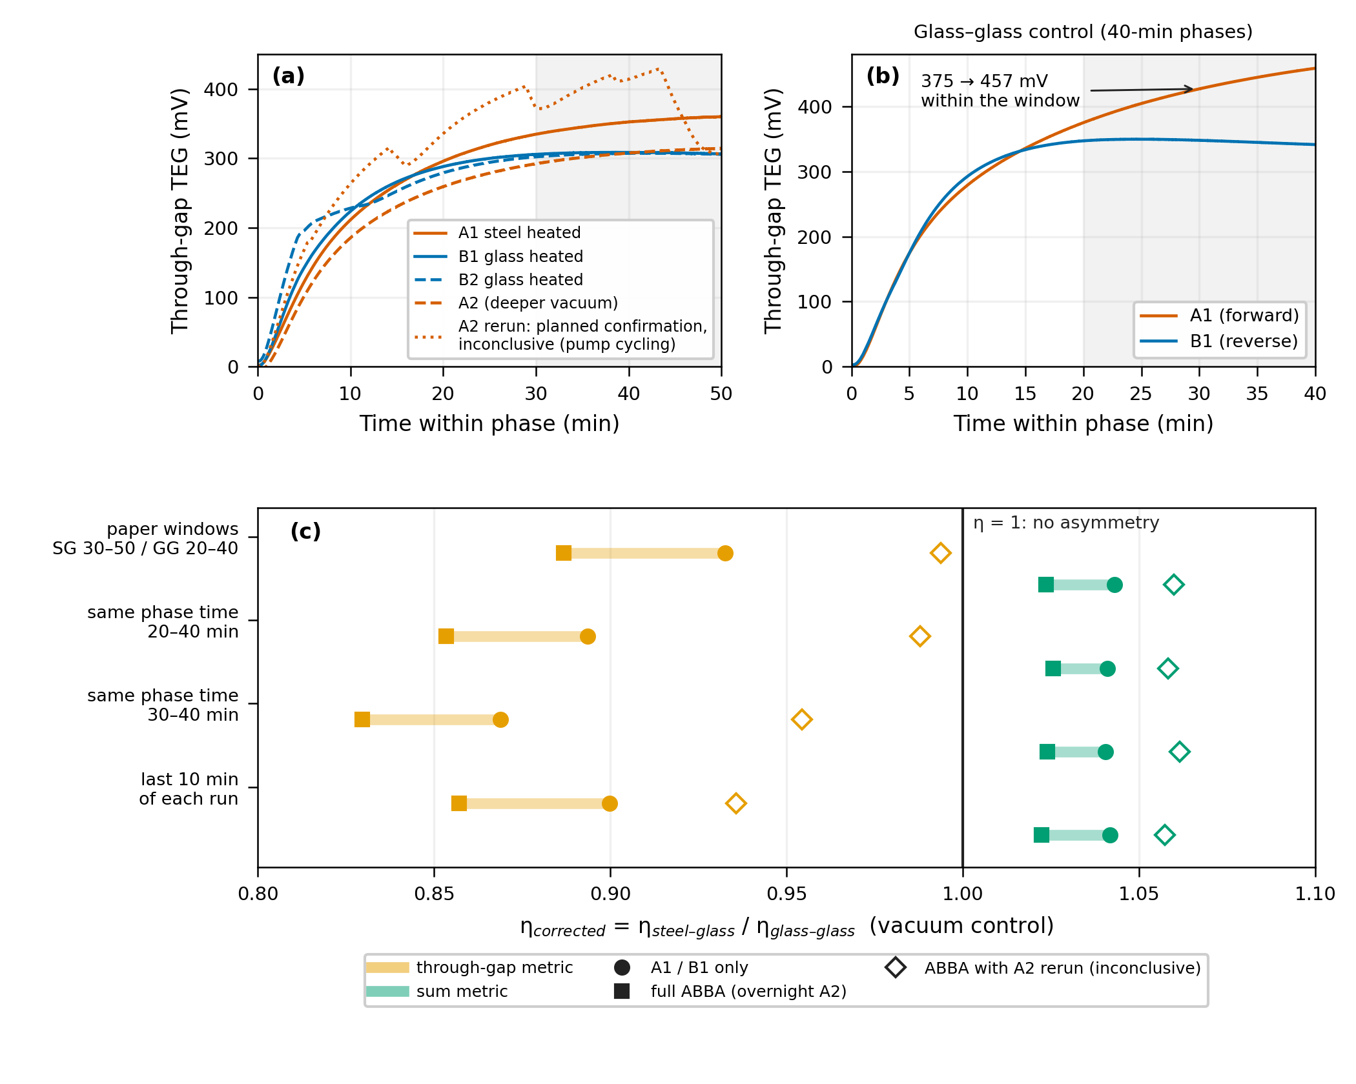
figures/paper/fig6_vacuum_result.png
