nikhi-s/microgap-thermal/figures/regenerated/plot5_key_result.png

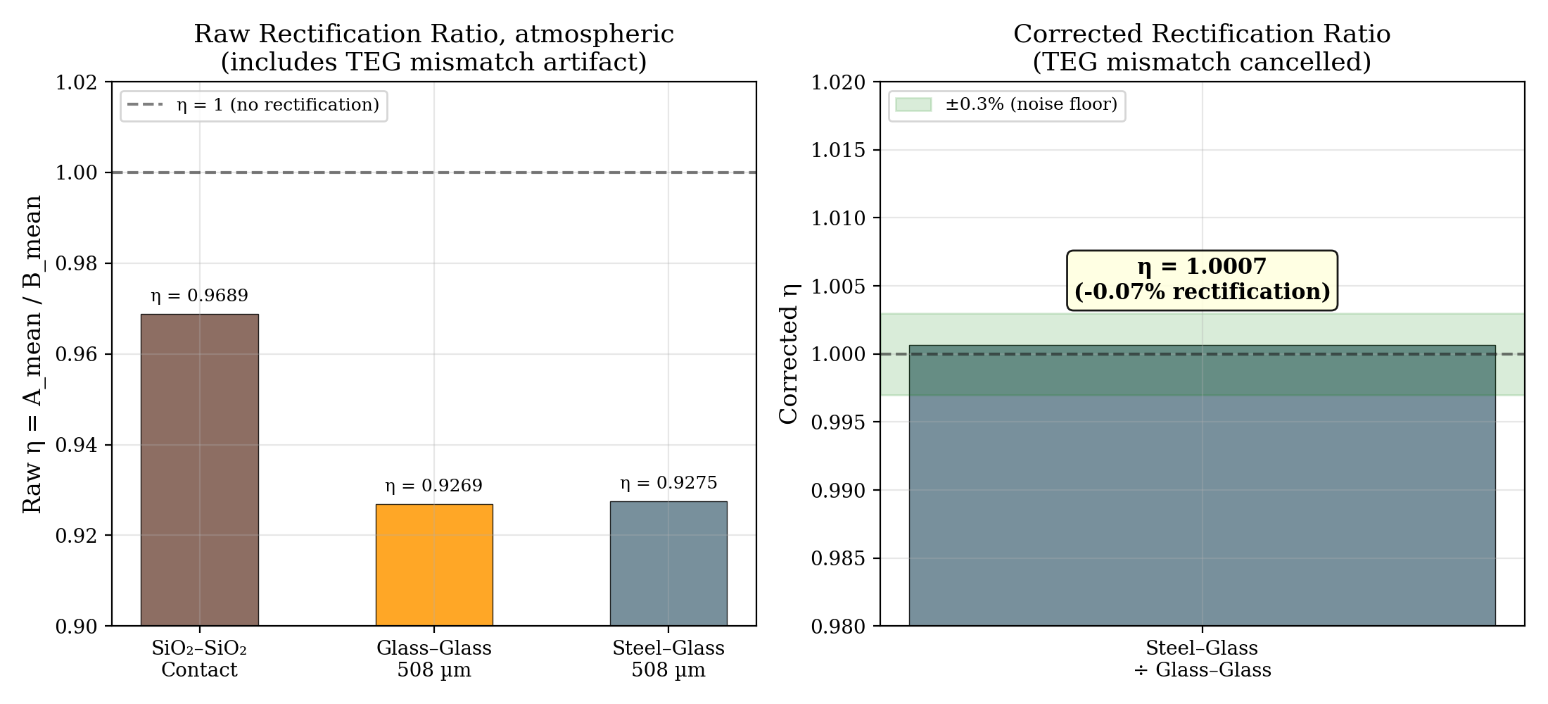
figures/regenerated/plot5_key_result.png
