nikhi-s/microgap-thermal/simulations/figures/sim2_rectification.pdf

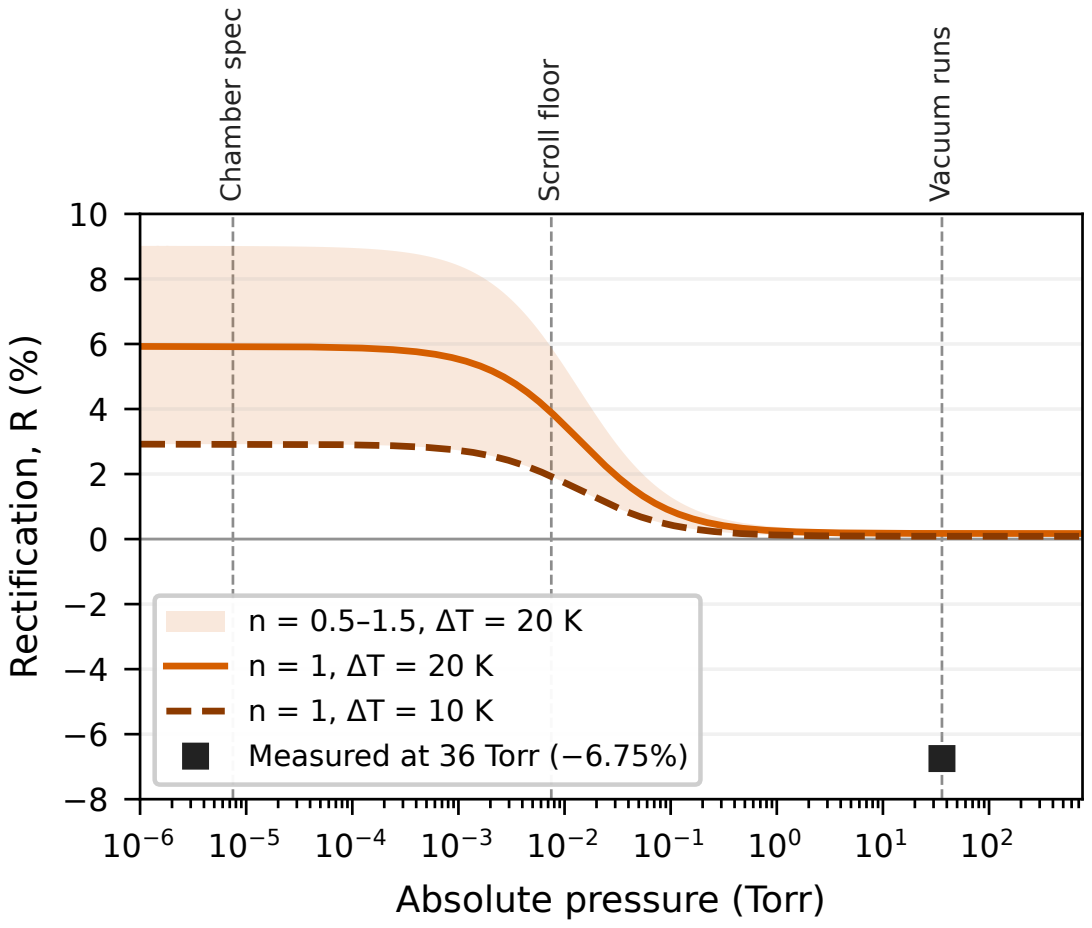
[picture p45: page 1]
Rectification, R (%); Chamber spec; Scroll floor; Vacuum runs

Measured at 36 Torr (−6.75%)

Absolute pressure (Torr)
