nikhi-s/microgap-thermal/figures/paper/fig3_gap_sweep.pdf

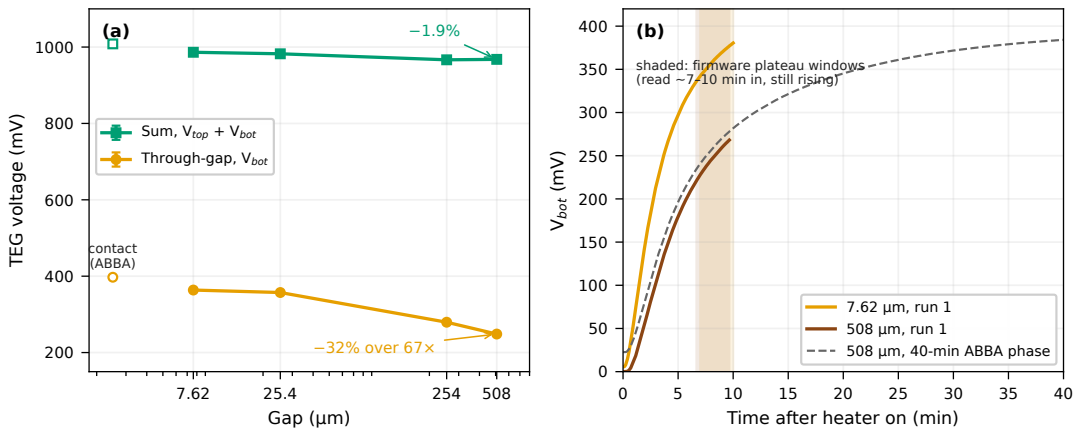
[picture p46: page 1]
Gap (µm); Vbot (m

(b) shaded: firmware plateau windows

(read ~7–10 min in, still rising)

TEG voltage (mV)

Sum, Vtop + Vbot
Through-gap, Vbot

contact (ABBA)

7.62 µm, run 1 508 µm, run 1

−32% over 67×

508 µm, 40-min ABBA phase

Time after heater on (min)
