nikhi-s/microgap-thermal/figures/paper/fig6_vacuum_result.pdf

(a)

(b)

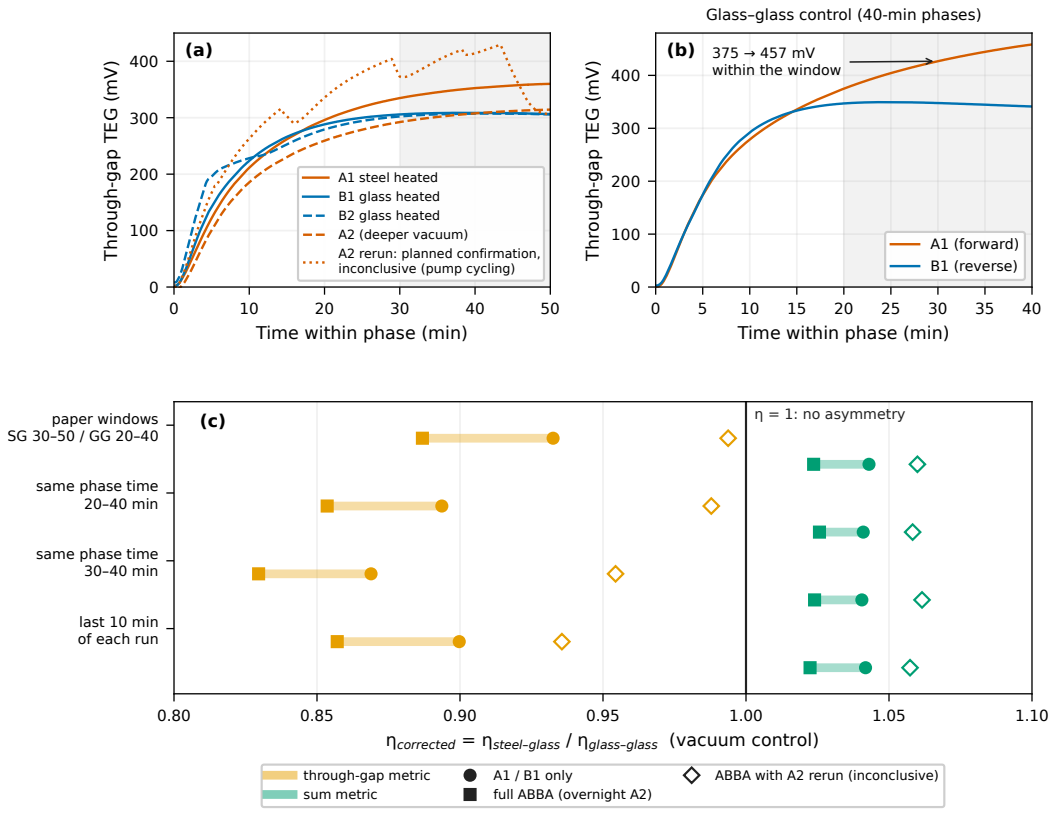
[picture p47: page 1]
A1 (forward) B1 (reverse); paper windows SG 30–50 / GG 20–40; η = 1: no asymmetry (c)

Glass–glass control (40-min phases)

within the window

Through-gap TEG (mV)

A1 steel heated
B1 glass heated
B2 glass heated
A2 (deeper vacuum)
A2 rerun: planned confirmation,
inconclusive (pump cycling)

Time within phase (min)

same phase time
20–40 min

30–40 min

last 10 min
of each run

ηcorrected = ηsteel–glass / ηglass–glass (vacuum control)

through-gap metric
sum metric

A1 / B1 only
full ABBA (overnight A2)

ABBA with A2 rerun (inconclusive)
