nikhi-s/microgap-thermal/figures/paper/fig7_gap_bound.pdf

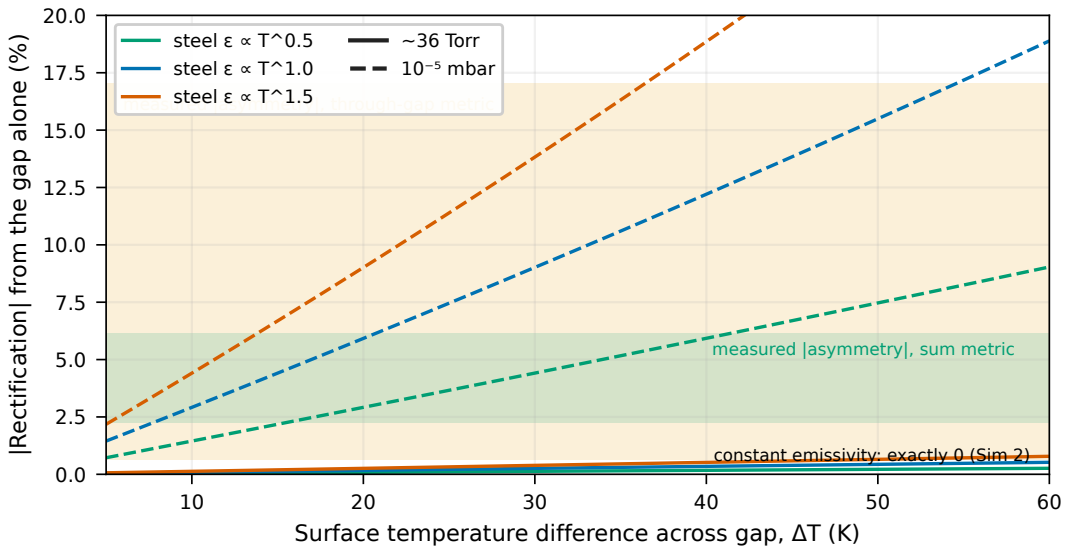
[picture p48: page 1]

Rectification| from the gap alone (%)

steel ε ∝ T^0.5 steel ε ∝ T^1.0 | ~36 Torr 10⁻⁵ mbar

steel ε ∝ T^1.5 measured |asymmetry|, through-gap metric

measured |asymmetry|, sum metric

constant emissivity: exactly 0 (Sim 2)

Surface temperature difference across gap, ΔT (K)
